Source-Robotics/RAFT-teleoperation-arm/datasheets/PAROL6_dims.png

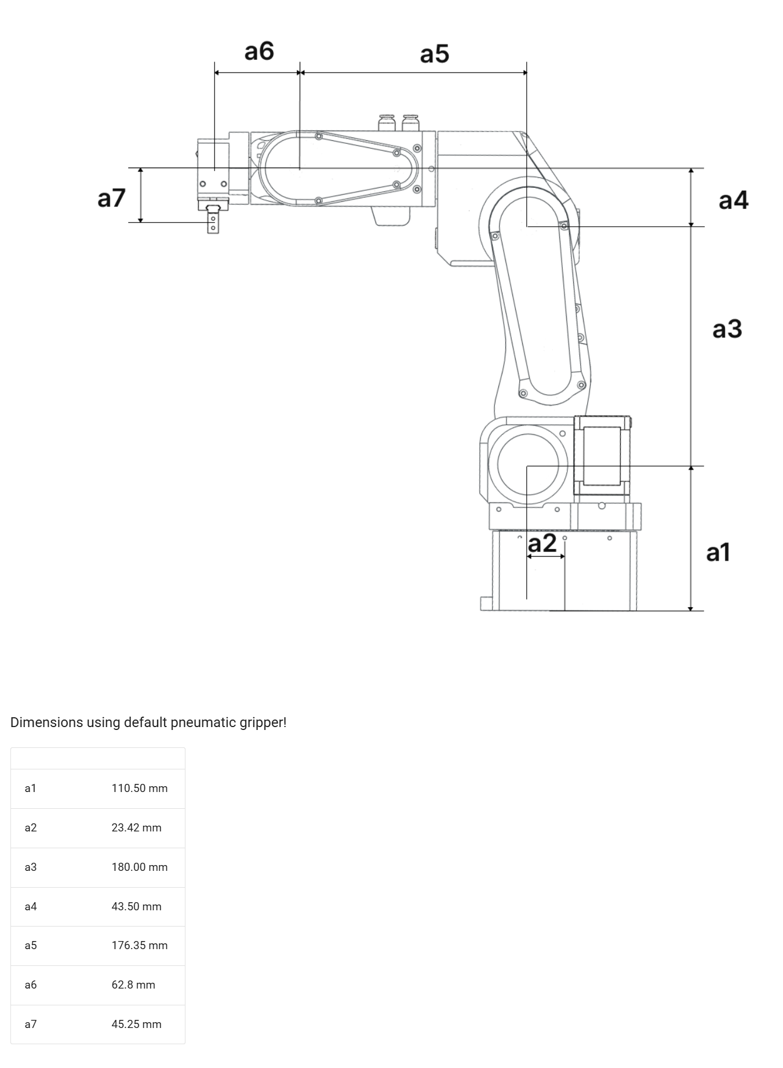
datasheets/PAROL6_dims.png
