Source-Robotics/RAFT-teleoperation-arm/Photos/render_back_dark.png

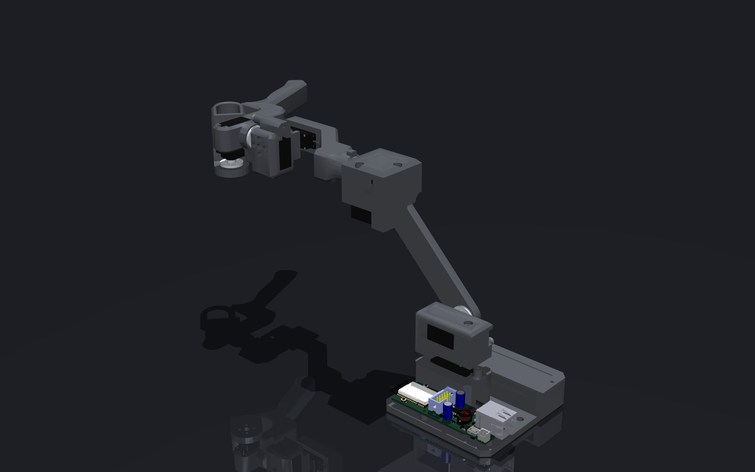
Photos/render_back_dark.png
