Source-Robotics/RAFT-teleoperation-arm/Photos/render_poses_dark.png

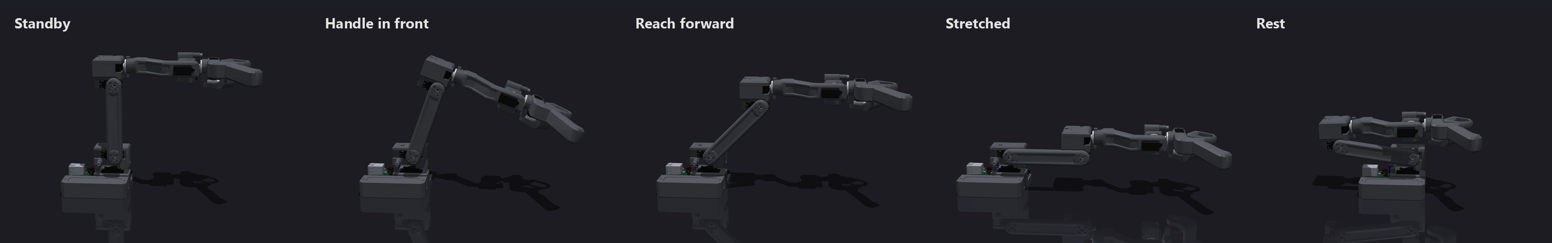
Photos/render_poses_dark.png
