Source-Robotics/RAFT-teleoperation-arm/BOM reference images/README.md

# BOM reference images

Pictures for the rows of [`BOM.md`](../BOM.md), to help find the same or an equivalent part from another supplier.
Each picture keeps its own licence. The CERN-OHL-S and GPL licences of this repository do not cover them.

| File | What | Source | Licence |
|---|---|---|---|
| `HLS3606M_servo.jpg` | The HLS3606M and what comes in its box: lead, aluminium horn, screws, splitter board, plastic horns | Feetech, from the HLS3606 datasheet ([`datasheets/HL_3606_C001_datasheet.pdf`](../datasheets/HL_3606_C001_datasheet.pdf)) | © Feetech |
| `ESP32-POE.jpg` | Olimex ESP32-PoE | Olimex, from the ESP32-POE user manual ([`datasheets/ESP32-POE-user-manual.pdf`](../datasheets/ESP32-POE-user-manual.pdf)) | © Olimex |
| `TTLinker_mini.jpg` | TTLinker mini | From the TTLinker datasheet ([`datasheets/TTLINKER.pdf`](../datasheets/TTLINKER.pdf)) | © its maker |
| `bench_power_supply.jpg` | A bench power supply | [Derrick Parker, Wikimedia Commons](https://commons.wikimedia.org/wiki/File:Bench_power_supply.jpg) | [CC0 1.0](https://creativecommons.org/publicdomain/zero/1.0/) |
| `toggle_switch.jpg` | A toggle switch | [Jason Zack (Jszack) at English Wikipedia, Wikimedia Commons](https://commons.wikimedia.org/wiki/File:On-Off_Switch.jpg) | [CC BY-SA 2.5](https://creativecommons.org/licenses/by-sa/2.5/) |
| `PoE_injector.jpg` | A PoE injector: data in, data and power out | [deavmi, Wikimedia Commons](https://commons.wikimedia.org/wiki/File:Power_over_Ethernet_injector.jpg) | [CC BY-SA 4.0](https://creativecommons.org/licenses/by-sa/4.0/) |
| `extension_spring.jpg` | An extension spring with a hook at each end | [Jean-Jacques MILAN, Wikimedia Commons](https://commons.wikimedia.org/wiki/File:Ressort_de_traction_%C3%A0_spires_jointives.jpg) | [CC BY-SA 3.0](https://creativecommons.org/licenses/by-sa/3.0/) |
| `braided_line.jpg` | Braided fishing line (Dyneema braid is sold this way) | [George Chernilevsky, Wikimedia Commons](https://commons.wikimedia.org/wiki/File:Fishing_lines_2025_G1.jpg) | [CC BY 4.0](https://creativecommons.org/licenses/by/4.0/) |
| `eyelet.png` | Ceramic thread-guide eyelet and a PTFE tube slice | Rendered for RAFT | CERN-OHL-S-2.0, as the rest of the hardware |

The Commons pictures are scaled down from the originals and otherwise unchanged.
