Source-Robotics/RAFT-teleoperation-arm/BOM reference images/bench_power_supply.jpg

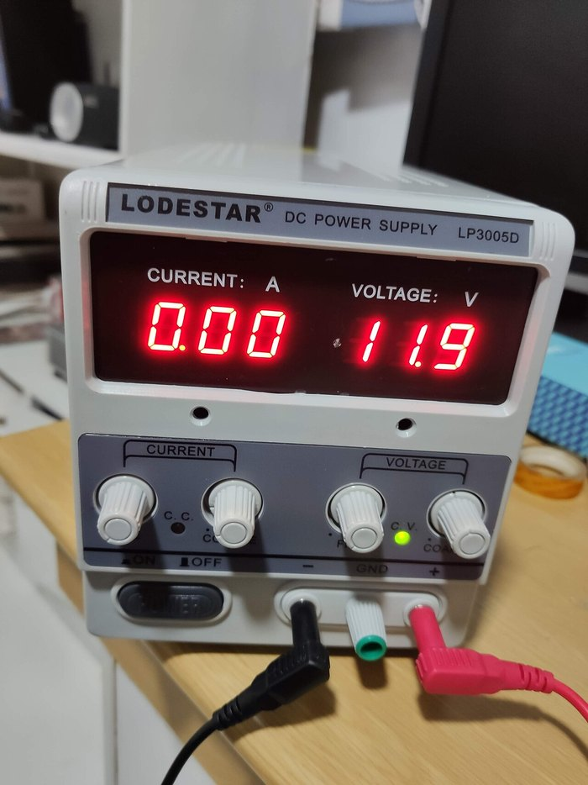
BOM reference images/bench_power_supply.jpg
