Source-Robotics/RAFT-teleoperation-arm/BOM reference images/braided_line.jpg

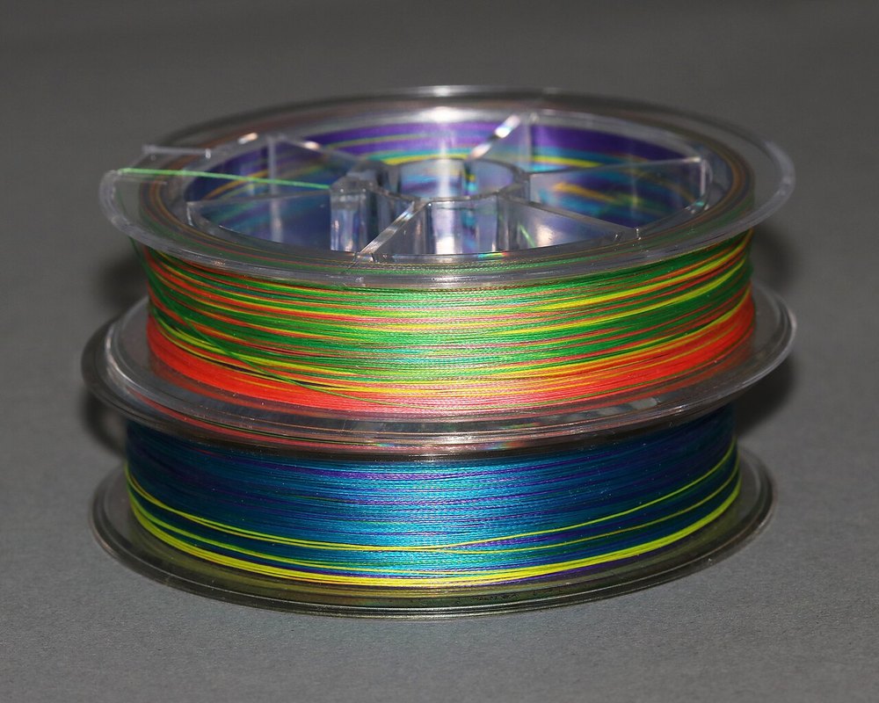
BOM reference images/braided_line.jpg
