Source-Robotics/RAFT-teleoperation-arm/BOM reference images/ESP32-POE.jpg

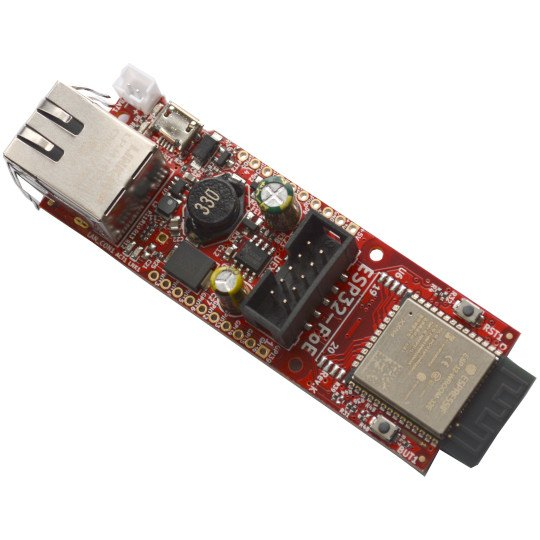
BOM reference images/ESP32-POE.jpg
