Source-Robotics/RAFT-teleoperation-arm/BOM reference images/extension_spring.jpg

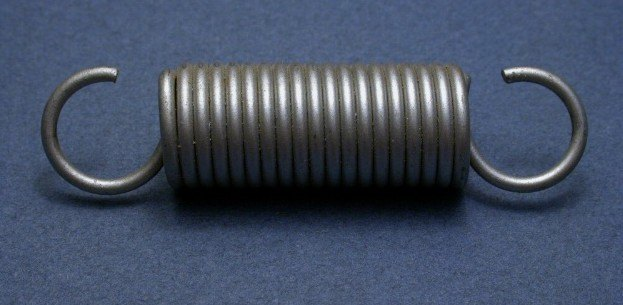
BOM reference images/extension_spring.jpg
