Source-Robotics/RAFT-teleoperation-arm/BOM reference images/eyelet.png

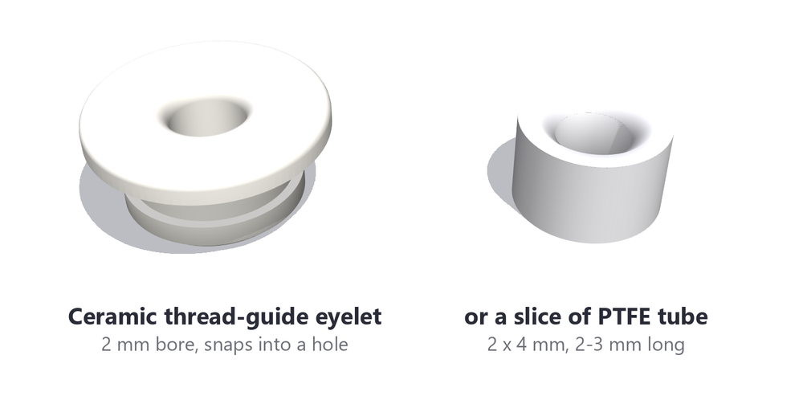
BOM reference images/eyelet.png
