Source-Robotics/RAFT-teleoperation-arm/BOM reference images/HLS3606M_servo.jpg

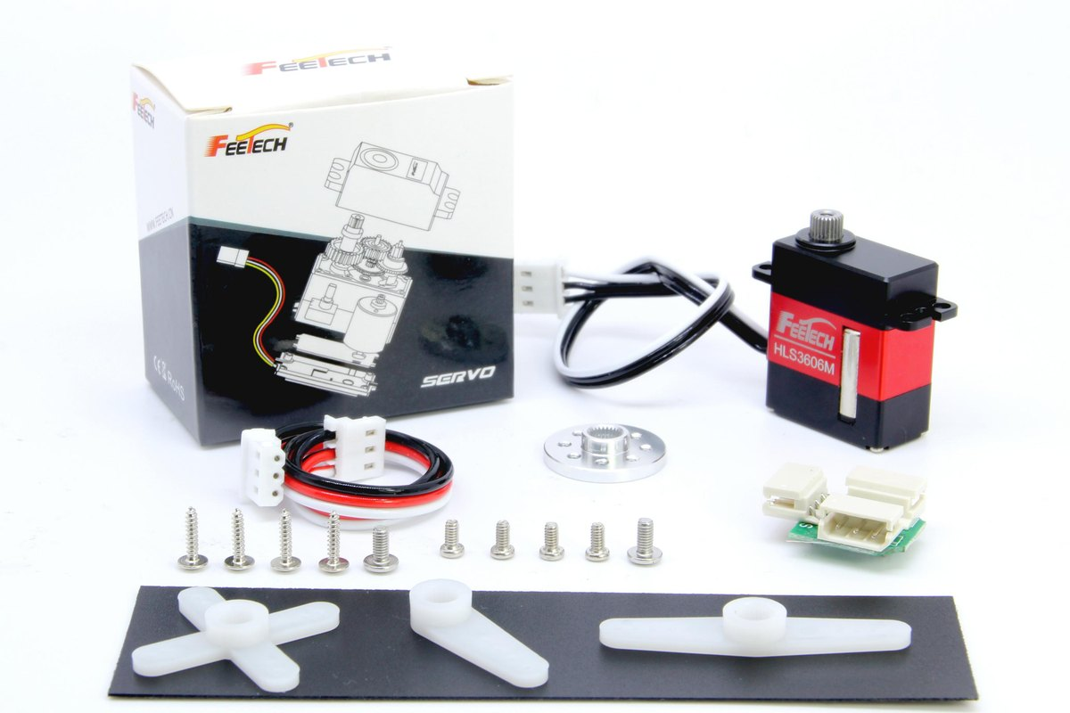
BOM reference images/HLS3606M_servo.jpg
