Source-Robotics/RAFT-teleoperation-arm/BOM reference images/PoE_injector.jpg

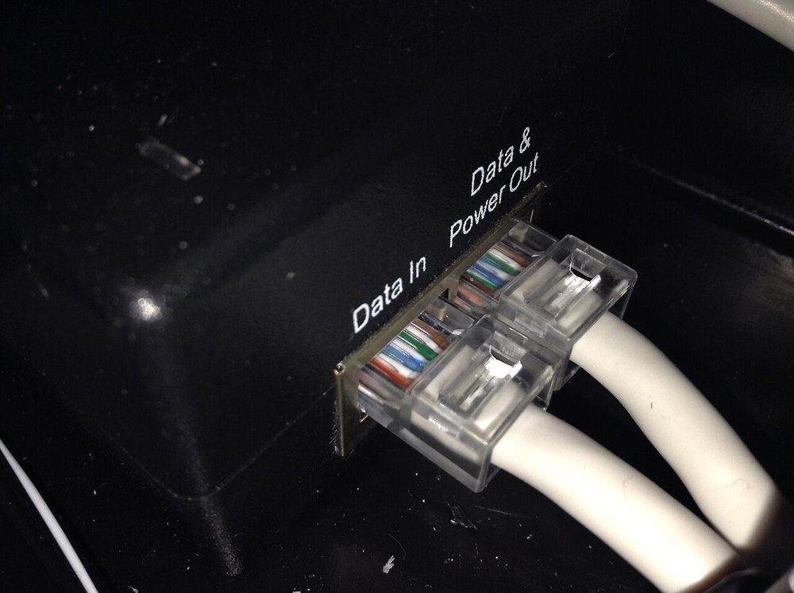
BOM reference images/PoE_injector.jpg
