Source-Robotics/RAFT-teleoperation-arm/BOM reference images/toggle_switch.jpg

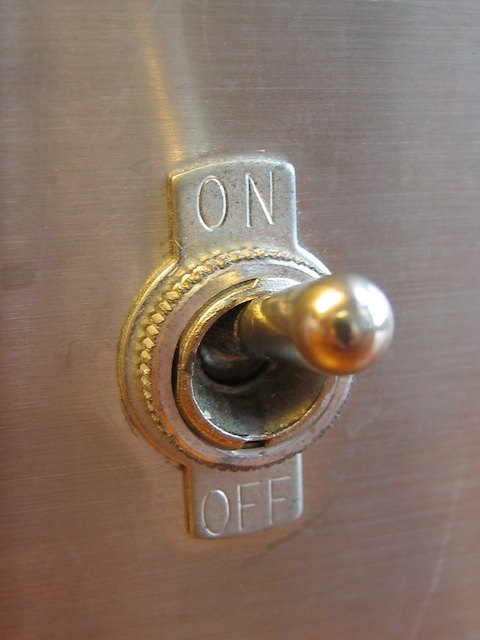
BOM reference images/toggle_switch.jpg
