Source-Robotics/RAFT-teleoperation-arm/BOM reference images/TTLinker_mini.jpg

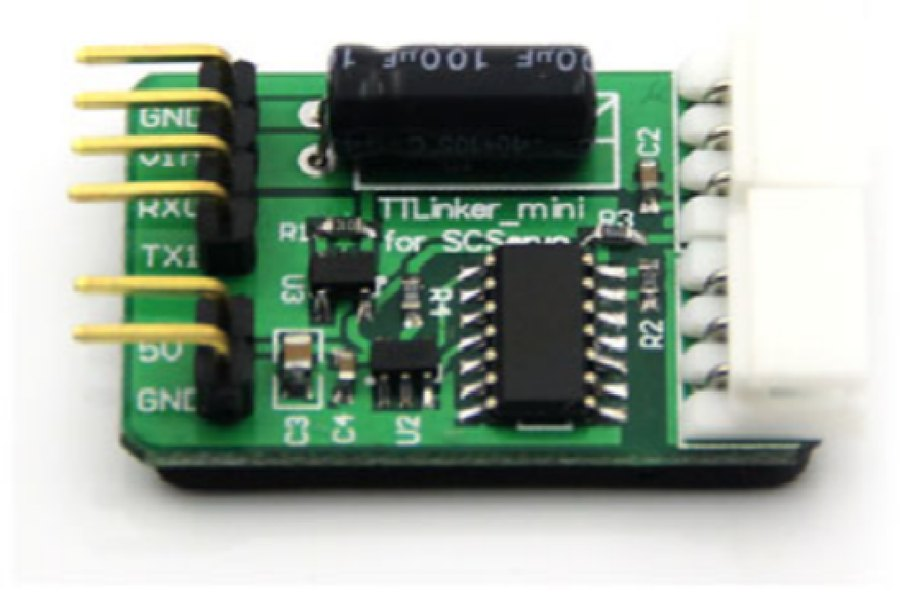
BOM reference images/TTLinker_mini.jpg
