Source-Robotics/RAFT-teleoperation-arm/3D print files/RAFT_BUNDLE_2.3mf

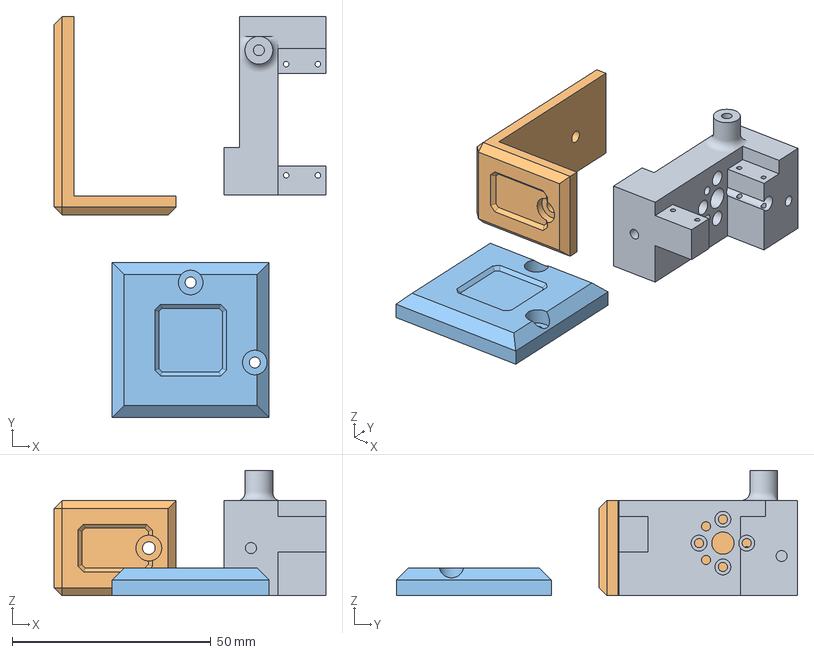
[picture p18: CAD file, 2026-05-04]
3D print files/RAFT_BUNDLE_2.3mf
68.4 x 101.0 x 31.6 mm
Part2^Assem1.STL
Part6^Assem1.STL
Part3^Assem1.STL
