Source-Robotics/RAFT-teleoperation-arm/firmware/tools/sim/model/meshes/link3.stl

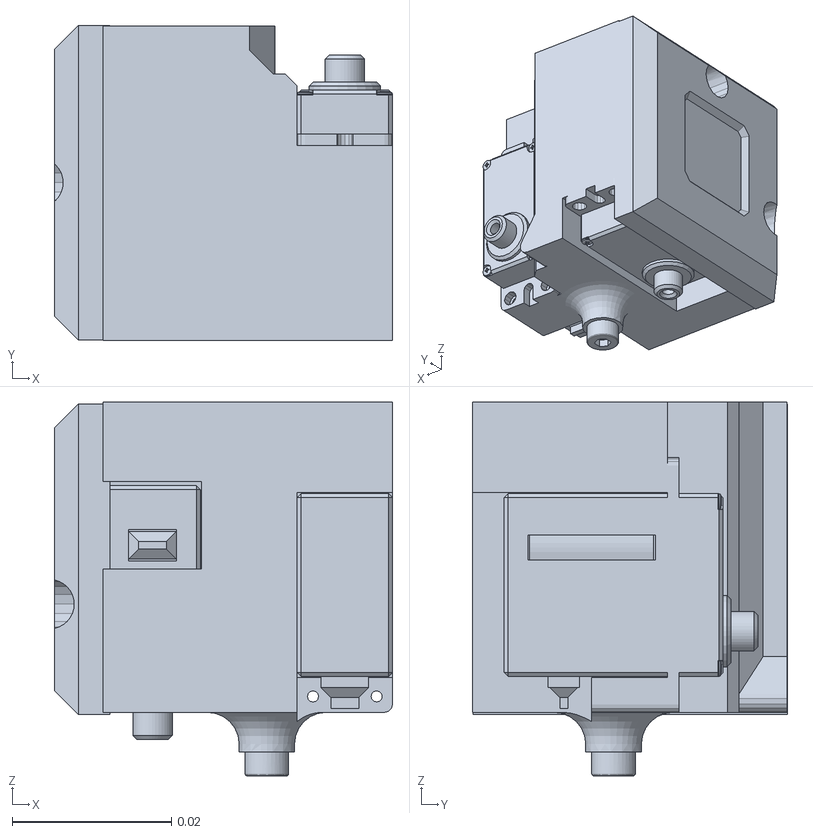
[picture p19: CAD file, 2026-11-05]
firmware/tools/sim/model/meshes/link3.stl
0.0425 x 0.0396 x 0.047
