Source-Robotics/RAFT-teleoperation-arm/STEP files/Lower_arm.STEP

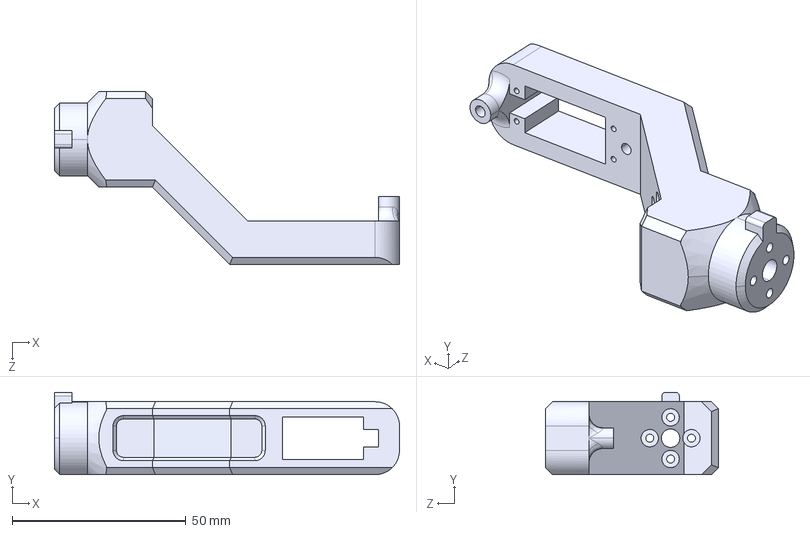
[picture p20: CAD file, 2026-05-04]
STEP files/Lower_arm.STEP
99.4 x 23.7 x 49.8 mm
