Source-Robotics/RAFT-teleoperation-arm/3D print files/RAFT_BUNDLE_1.3mf

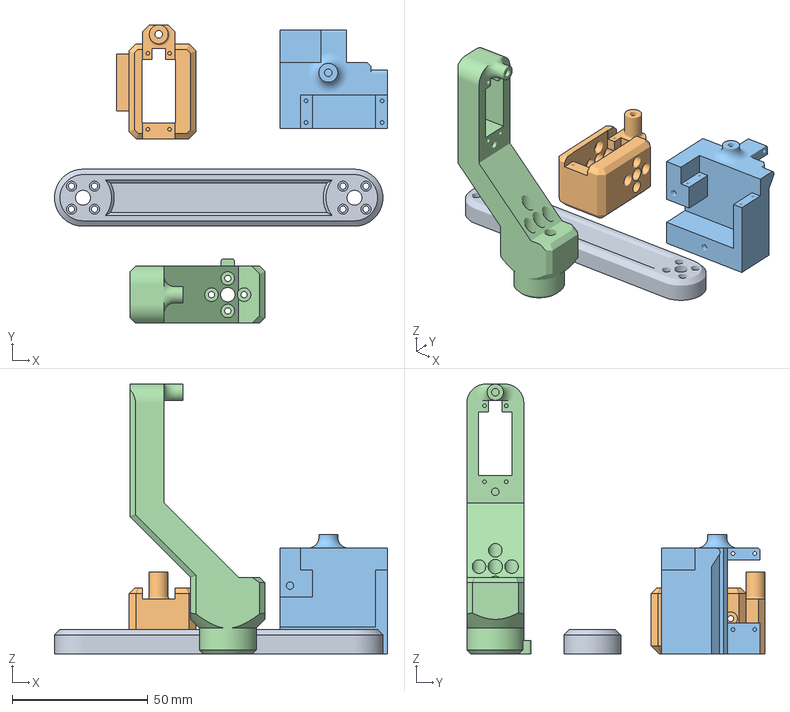
[picture p21: CAD file, 2026-05-04]
3D print files/RAFT_BUNDLE_1.3mf
122.7 x 109.9 x 99.4 mm
upper_Arm.STL
Part5^Assem1.STL
Part1^Assem1.STL
Part4^Assem1.STL
