Source-Robotics/RAFT-teleoperation-arm/firmware/tools/sim/model/meshes/link2.stl

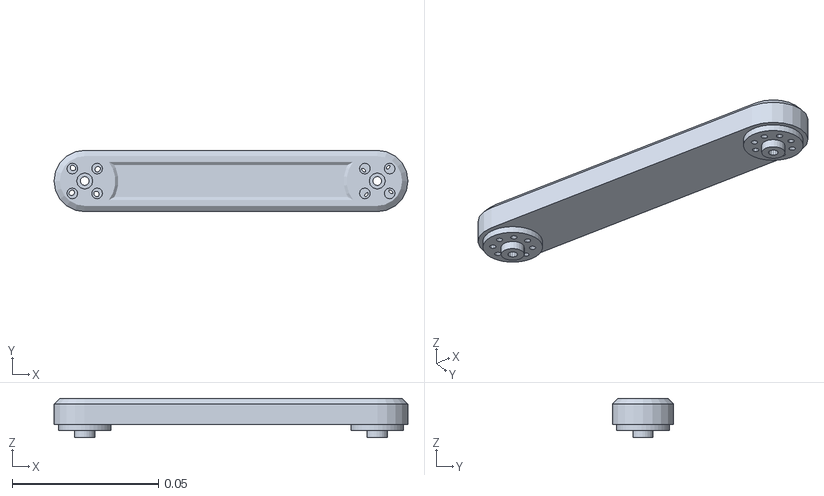
[picture p22: CAD file, 2026-11-05]
firmware/tools/sim/model/meshes/link2.stl
0.121 x 0.021 x 0.0135
