Source-Robotics/RAFT-teleoperation-arm/STEP files/Gripper_trigger.STEP

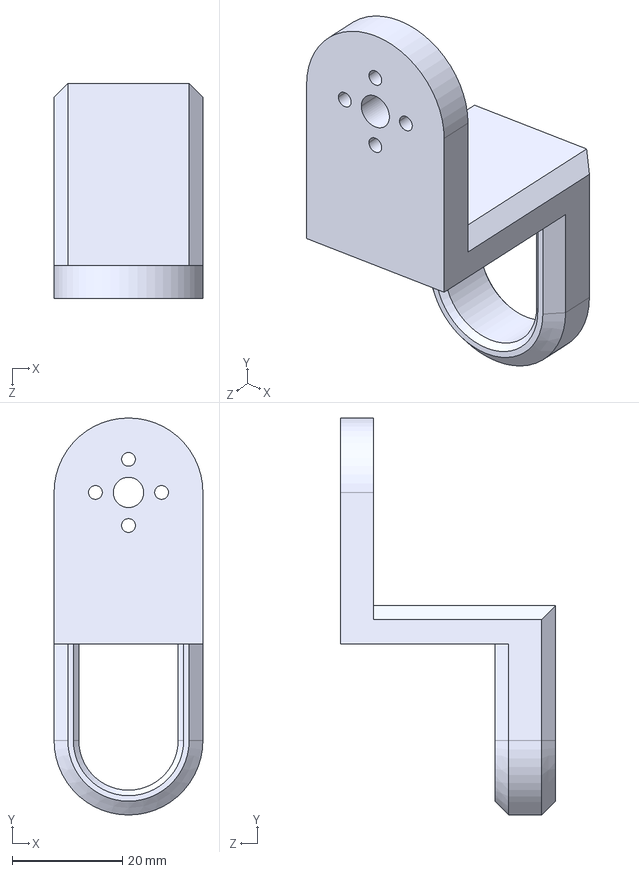
[picture p23: CAD file, 2026-05-04]
STEP files/Gripper_trigger.STEP
27.0 x 72.0 x 39.0 mm
