Source-Robotics/RAFT-teleoperation-arm/firmware/tools/sim/model/meshes/link4.stl

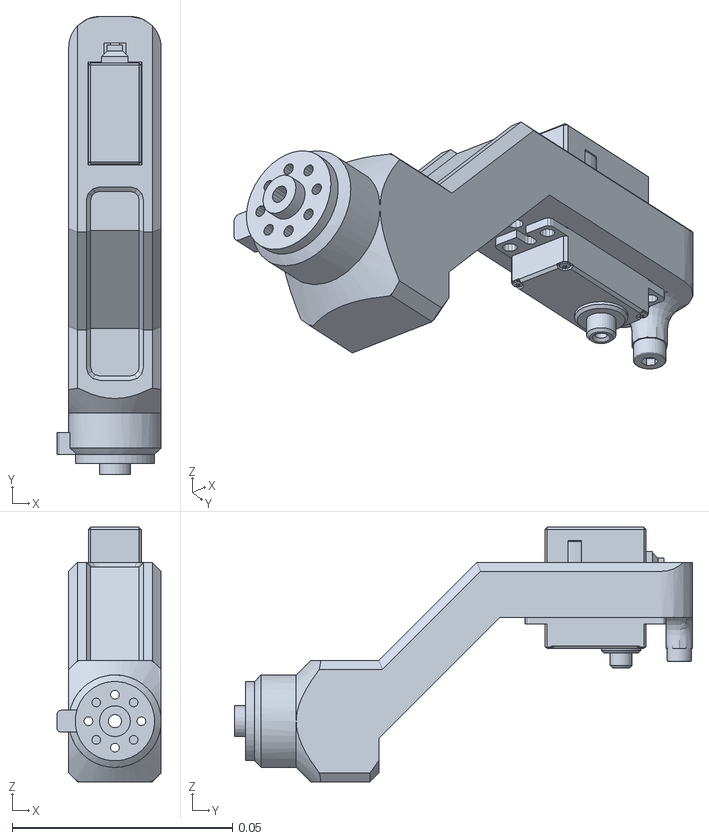
[picture p24: CAD file, 2026-11-05]
firmware/tools/sim/model/meshes/link4.stl
0.0237 x 0.104 x 0.0578
