Source-Robotics/RAFT-teleoperation-arm/STEP files/Wrist.STEP

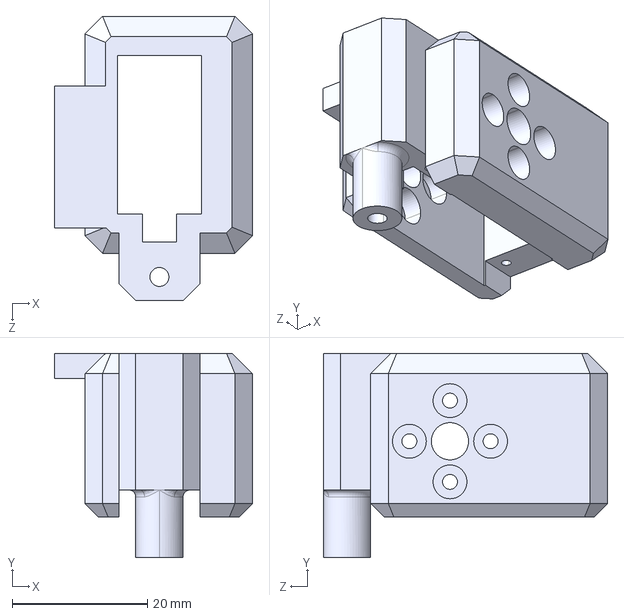
[picture p25: CAD file, 2026-05-04]
STEP files/Wrist.STEP
29.3 x 30.2 x 42.0 mm
