Source-Robotics/RAFT-teleoperation-arm/firmware/tools/sim/model/meshes/link1.stl

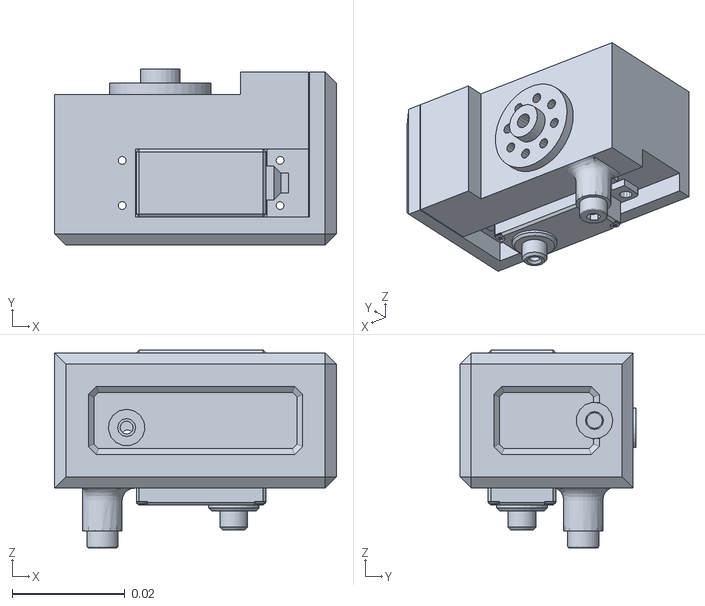
[picture p26: CAD file, 2026-11-05]
firmware/tools/sim/model/meshes/link1.stl
0.05 x 0.0312 x 0.0351
