Source-Robotics/RAFT-teleoperation-arm/STEP files/Elbow_llid.STEP

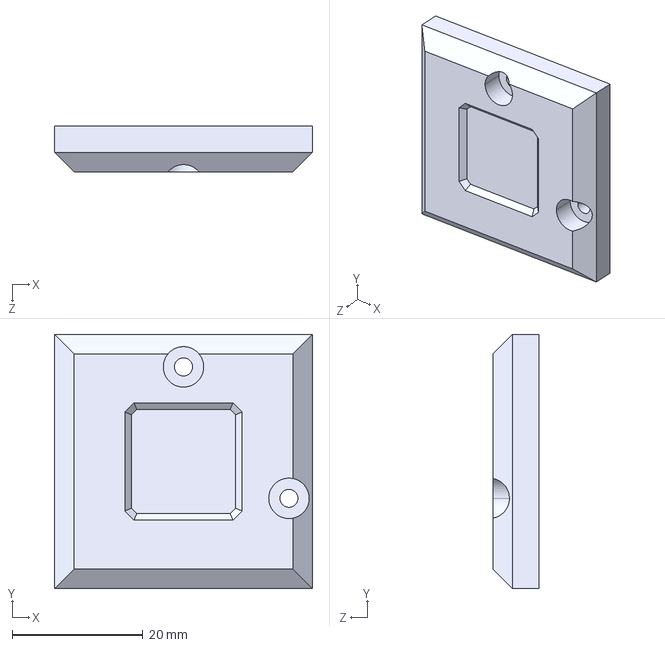
[picture p27: CAD file, 2026-05-04]
STEP files/Elbow_llid.STEP
39.5 x 39.0 x 7.00 mm
