Source-Robotics/RAFT-teleoperation-arm/firmware/tools/sim/model/meshes/link5.stl

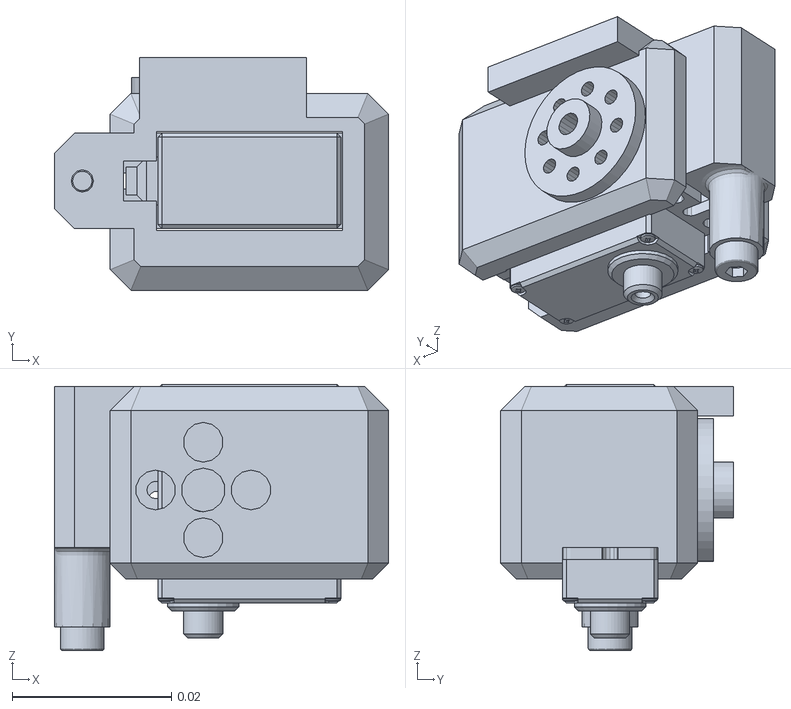
[picture p28: CAD file, 2026-11-05]
firmware/tools/sim/model/meshes/link5.stl
0.042 x 0.0292 x 0.0335
