Source-Robotics/RAFT-teleoperation-arm/STEP files/Shoulder.STEP

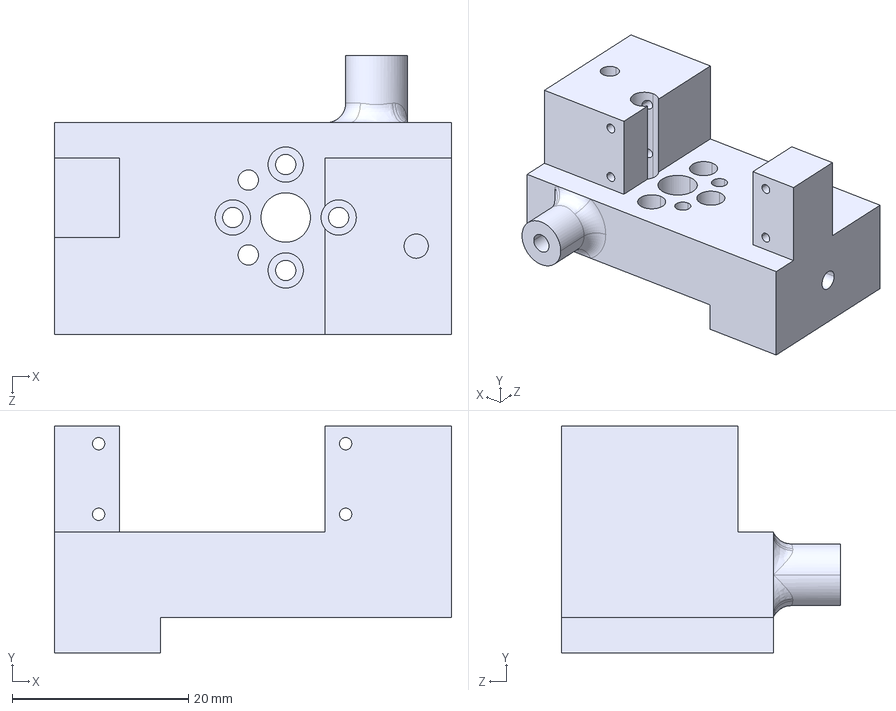
[picture p29: CAD file, 2026-05-04]
STEP files/Shoulder.STEP
45.0 x 25.7 x 31.6 mm
