Source-Robotics/RAFT-teleoperation-arm/firmware/tools/sim/model/meshes/base_link.stl

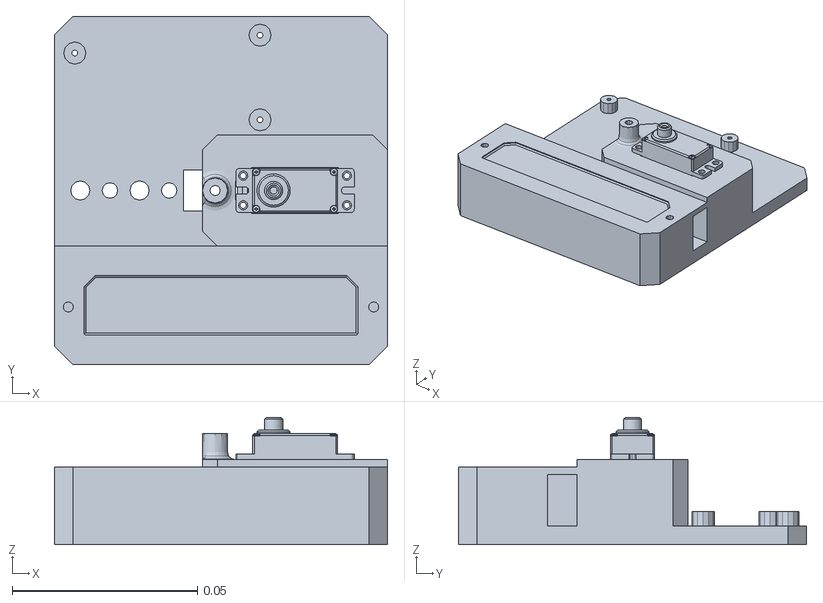
[picture p30: CAD file, 2026-11-05]
firmware/tools/sim/model/meshes/base_link.stl
0.09 x 0.094 x 0.0344
