Source-Robotics/RAFT-teleoperation-arm/STEP files/Gripper_handle.STEP

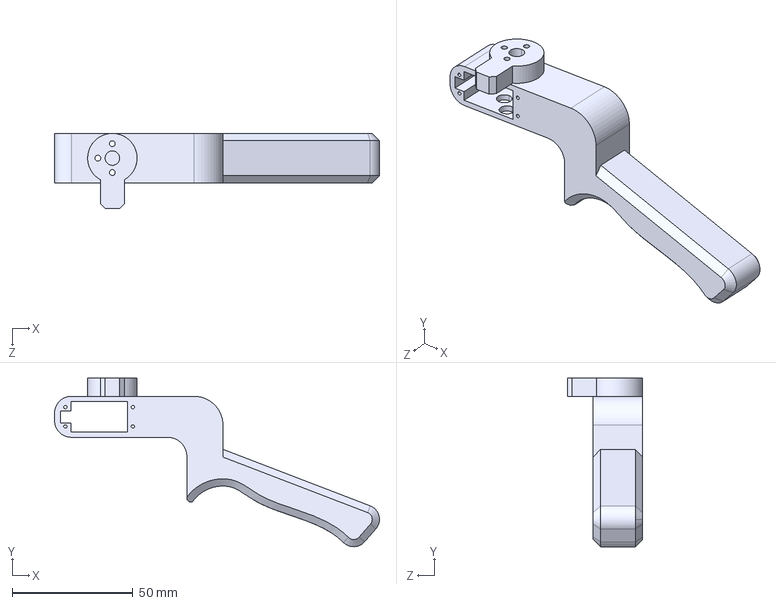
[picture p31: CAD file, 2026-05-04]
STEP files/Gripper_handle.STEP
134.8 x 69.9 x 31.2 mm
