Source-Robotics/RAFT-teleoperation-arm/firmware/tools/sim/model/meshes/gripper_trigger.stl

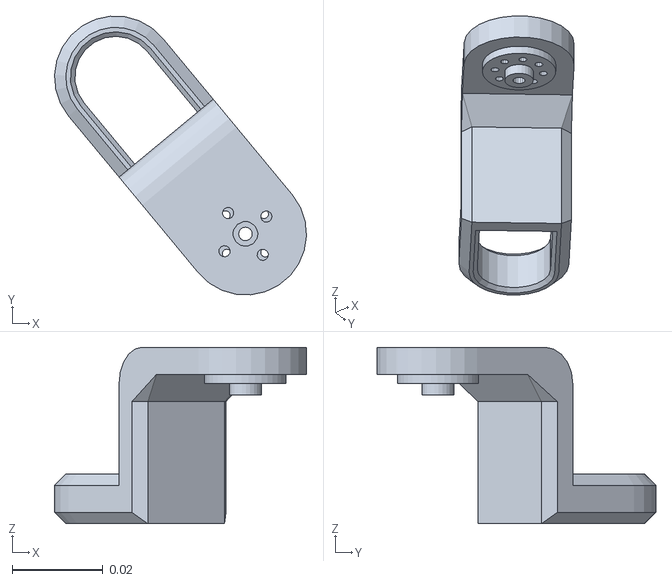
[picture p32: CAD file, 2026-11-05]
firmware/tools/sim/model/meshes/gripper_trigger.stl
0.0557 x 0.0616 x 0.039
