Source-Robotics/RAFT-teleoperation-arm/STEP files/Shoulder_lid.STEP

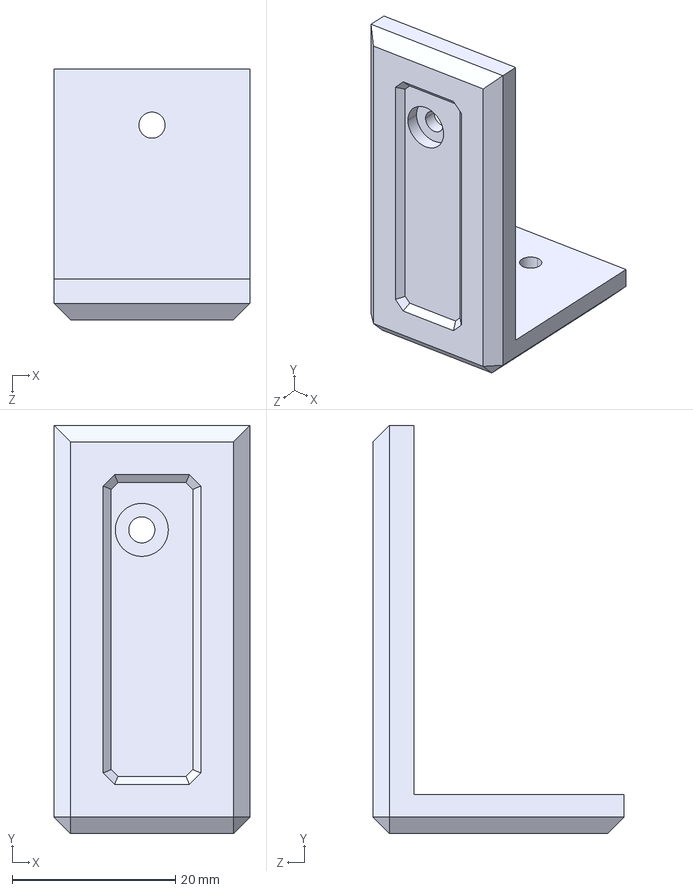
[picture p33: CAD file, 2026-05-04]
STEP files/Shoulder_lid.STEP
24.0 x 50.0 x 30.7 mm
