Source-Robotics/RAFT-teleoperation-arm/firmware/tools/sim/model/meshes/link6.stl

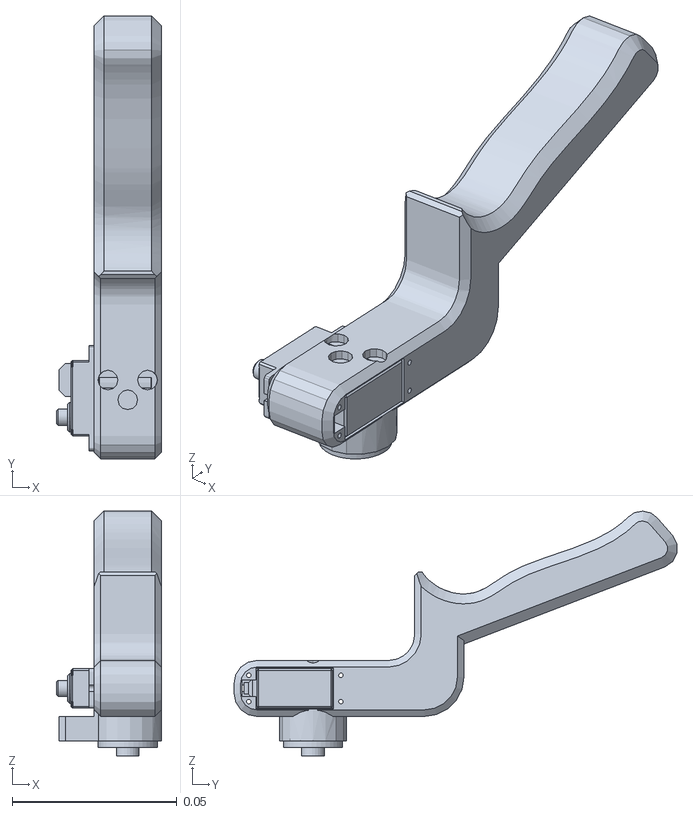
[picture p34: CAD file, 2026-11-05]
firmware/tools/sim/model/meshes/link6.stl
0.0319 x 0.135 x 0.0744
