Source-Robotics/RAFT-teleoperation-arm/STEP files/Base_lid.STEP

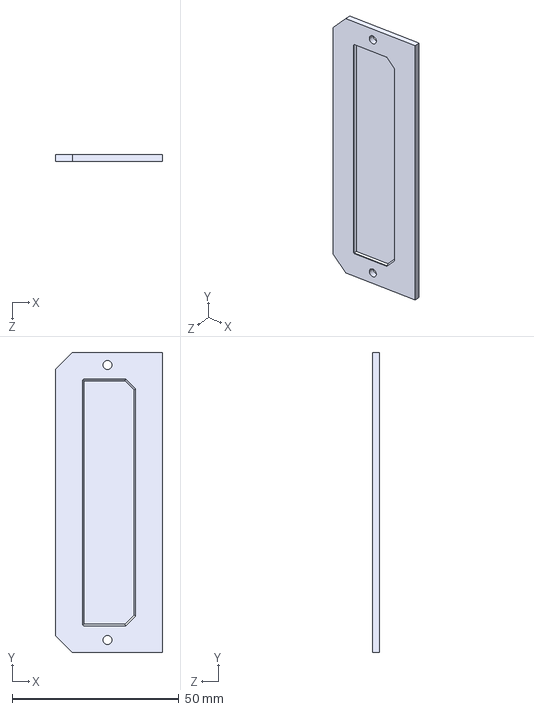
[picture p35: CAD file, 2026-05-04]
STEP files/Base_lid.STEP
32.0 x 90.0 x 2.00 mm
