Source-Robotics/RAFT-teleoperation-arm/STEP files/Upper_arm.STEP

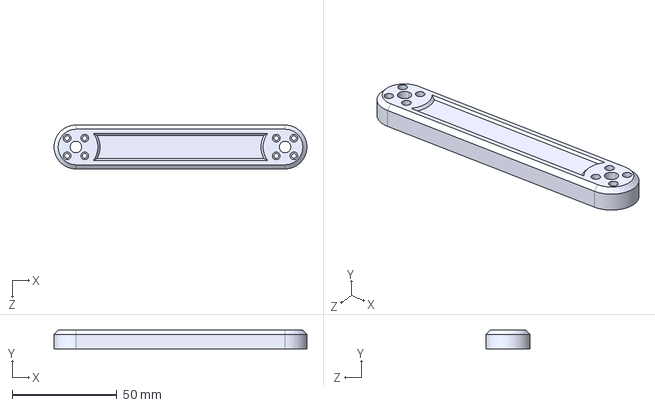
[picture p36: CAD file, 2026-05-04]
STEP files/Upper_arm.STEP
121.0 x 9.00 x 21.0 mm
