Source-Robotics/RAFT-teleoperation-arm/STEP files/Base.STEP

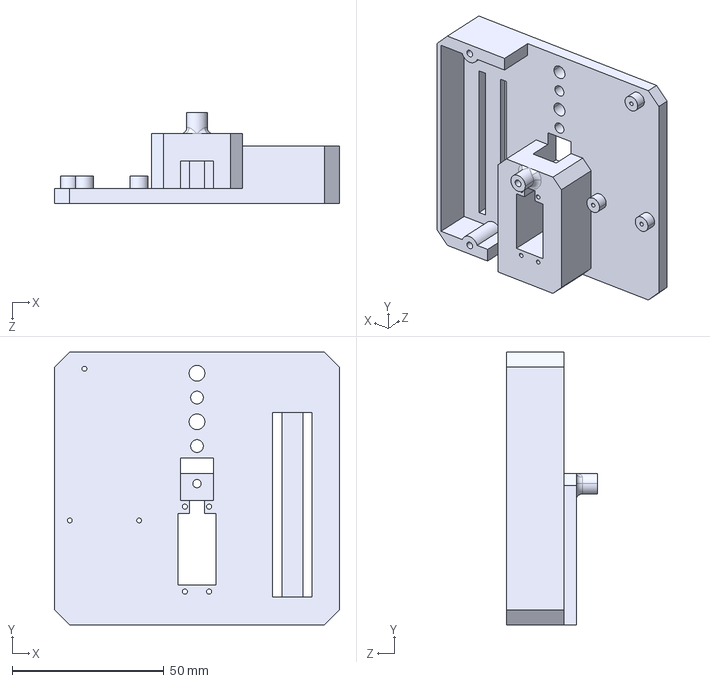
[picture p37: CAD file, 2026-05-04]
STEP files/Base.STEP
94.0 x 90.0 x 30.0 mm
