Source-Robotics/RAFT-teleoperation-arm/STEP files/Elbow.STEP

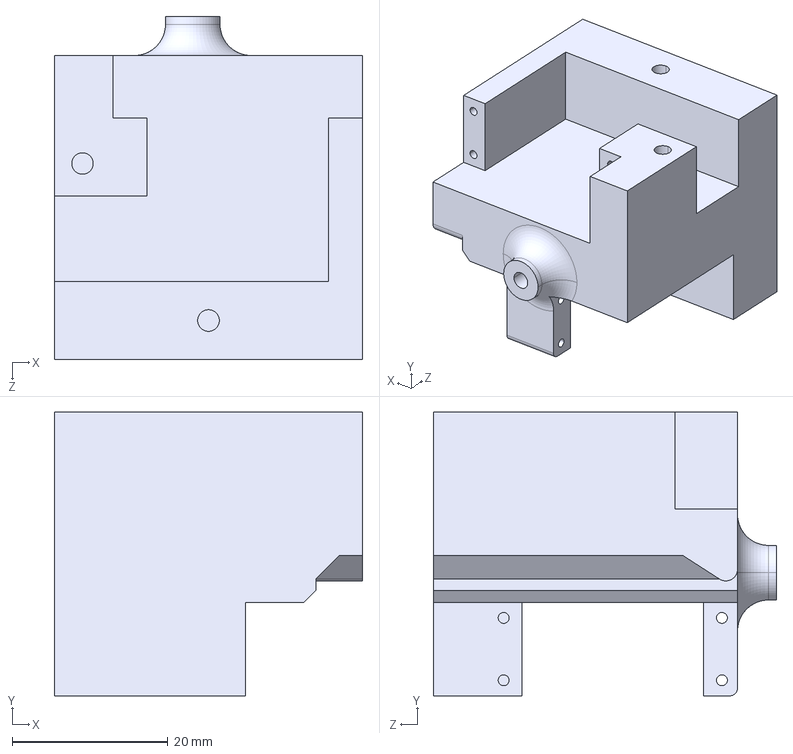
[picture p38: CAD file, 2026-05-04]
STEP files/Elbow.STEP
39.5 x 36.4 x 44.0 mm
