Source-Robotics/RAFT-teleoperation-arm/3D print files/RAFT Teleop Arm Print Table - Sheet1.pdf

We used a Prusa MK4 with the default Prusament PETG filament profile. To ensure your RAFT robot functions properly, please try to match these print settings on your own printer. While the mass doesn't need to be exact for every part, you should aim for the values listed in the table once your model is sliced. Note: Make sure to deduct the mass of any support

### material! Mass in the table is for the parts without any support material!

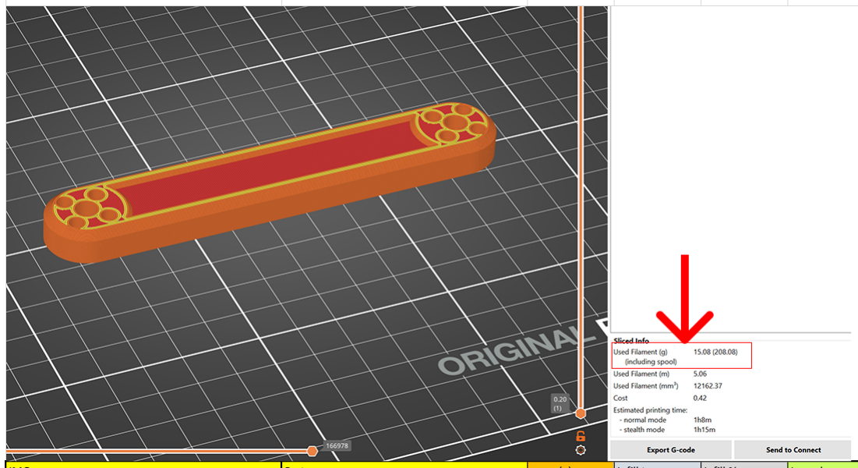
[picture p55: figure]
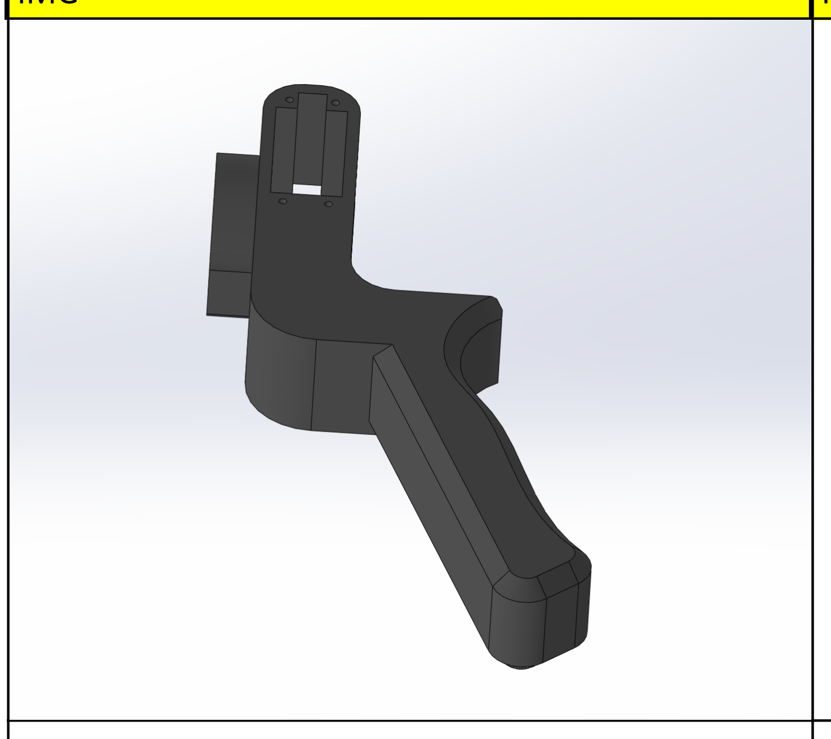
[picture p56: figure]

IMG | Part name | mass (g) | Infill type | Infill % | Layer h | Top layers | Bot layers | Perimeters
| Gripper handle | 33 | honey | 25 | 0.15 | 6 | 5 | 3

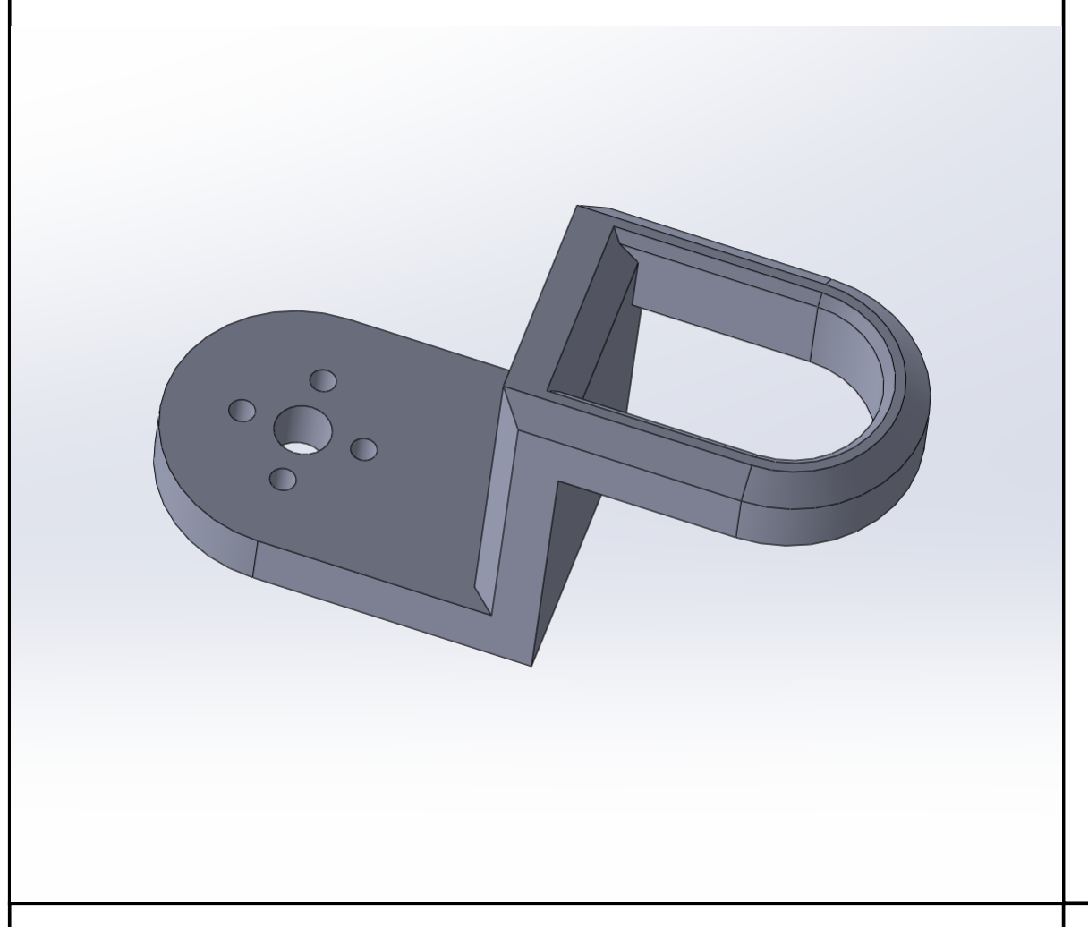
[picture p57: figure]

| Gripper trigger | 13 | honey | 25 | 0.15 | 6 | 5 | 3

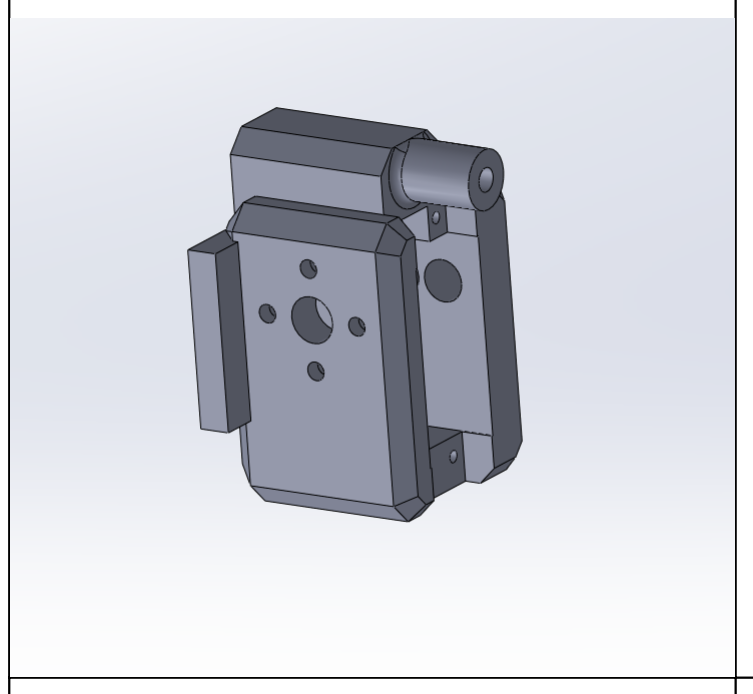
[picture p58: figure]

| Wrist | 12.7 | honey | 25 | 0.15 | 6 | 5 | 3

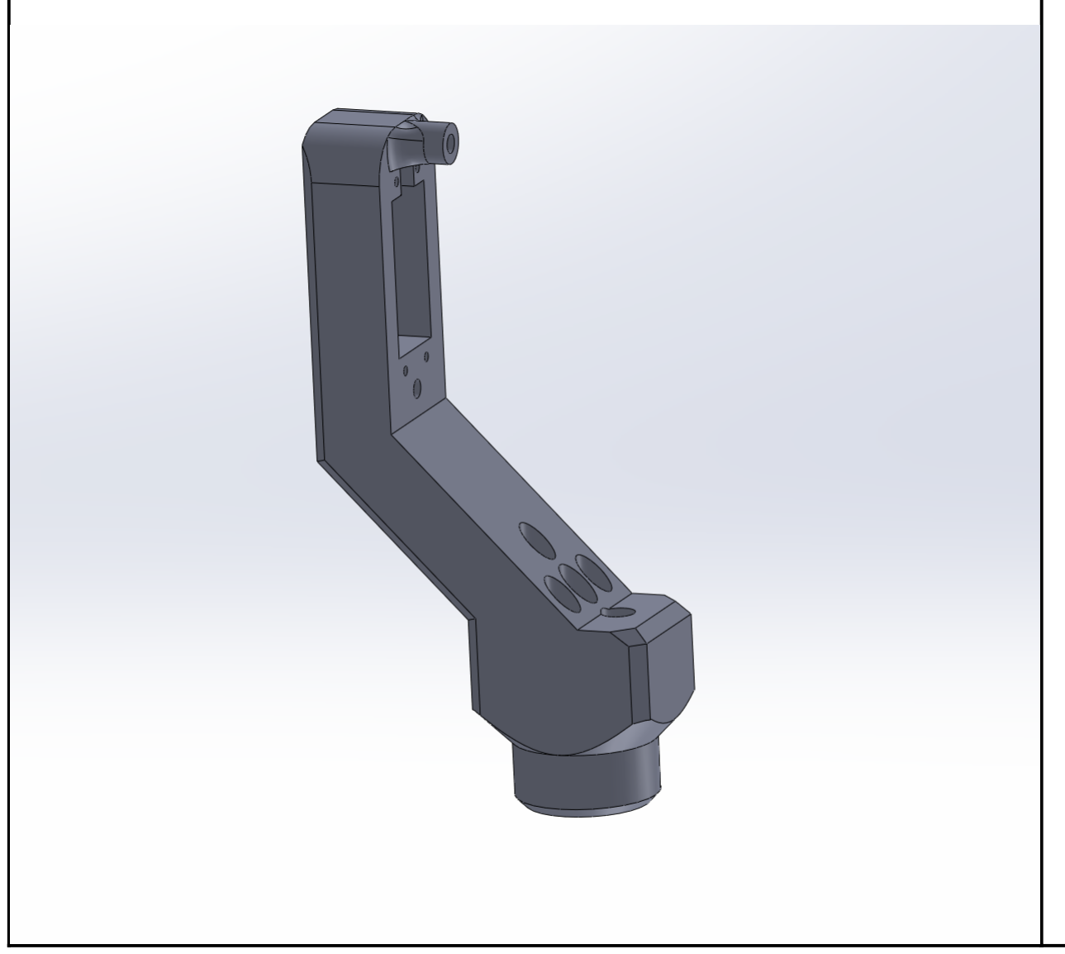
[picture p59: figure]

| Lower arm | 23.7 | honey | 25 | 0.15 | 6 | 5 | 3

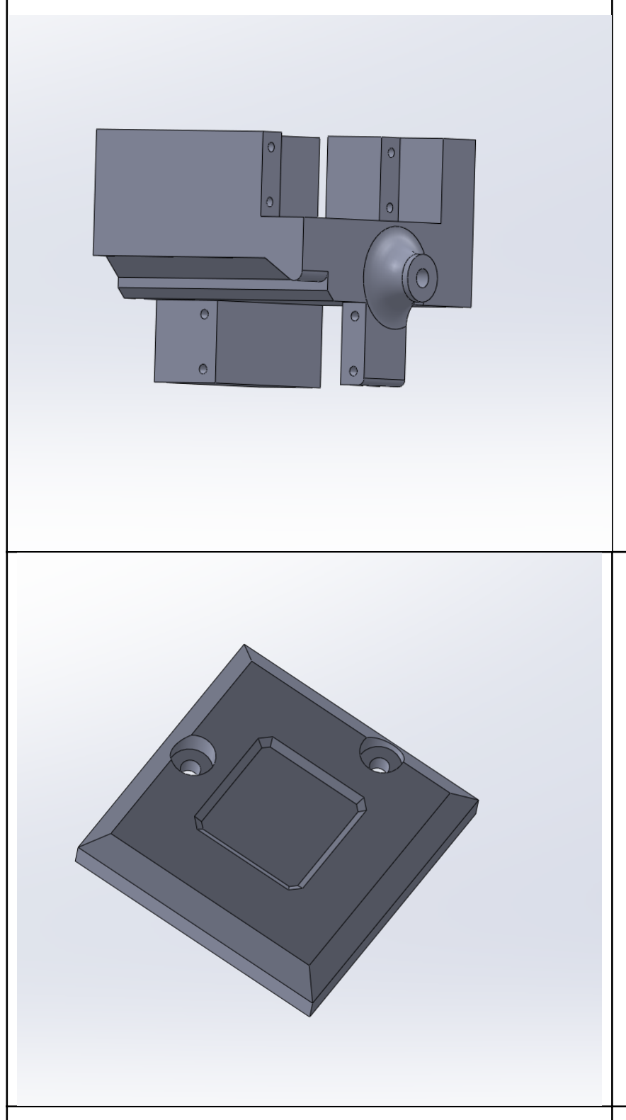
[picture p60: figure]

Elbow | 21.7 | honey | 25 | 0.15 | 6 | 5 | 3
Elbow lid | 7.6 | honey | 25 | 0.15 | 6 | 5 | 3

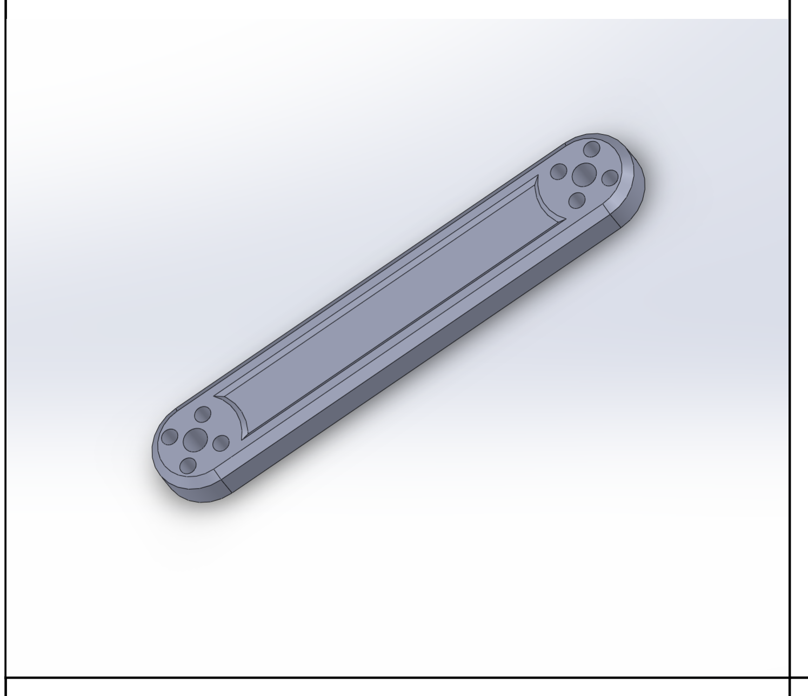
[picture p61: figure]

Upper arm | 15.6 | honey | 25 | 0.15 | 6 | 5 | 3

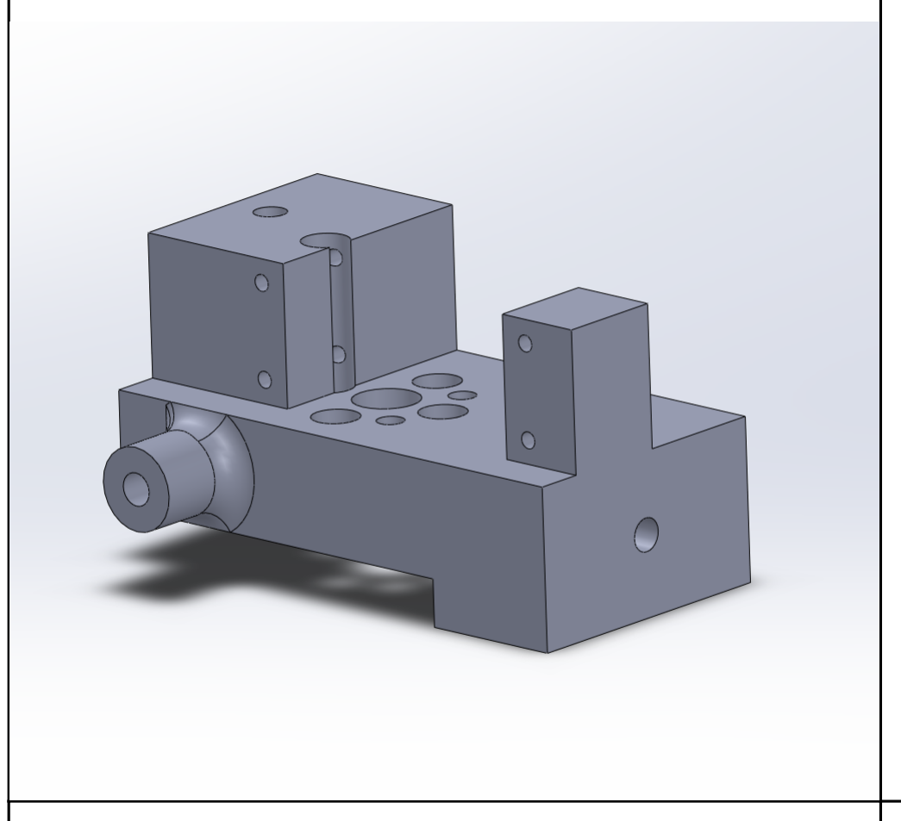
[picture p62: figure]

Shoulder | 13 | honey | 25 | 0.15 | 6 | 5 | 3

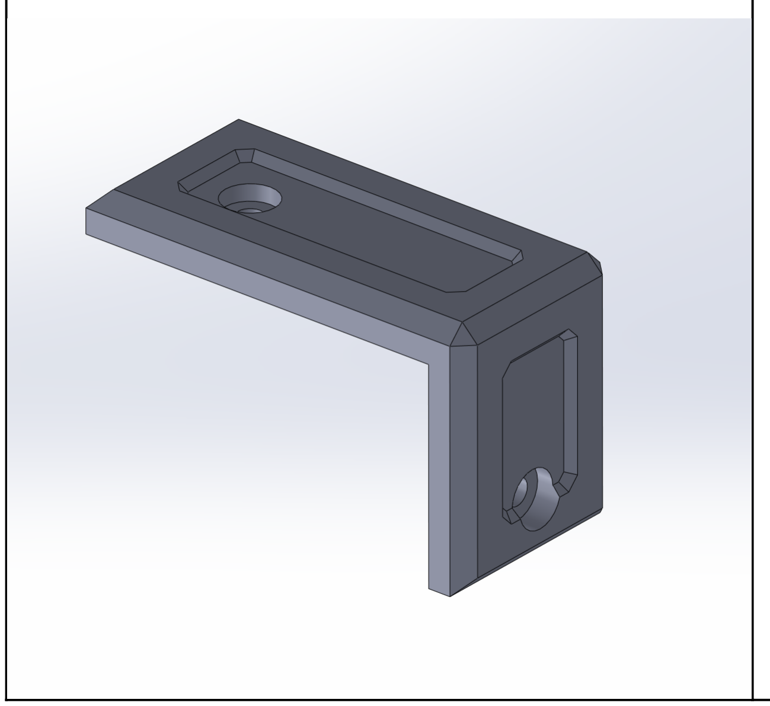
[picture p63: figure]

Shoulder lid | 7.8 | honey | 25 | 0.15 | 6 | 5 | 3

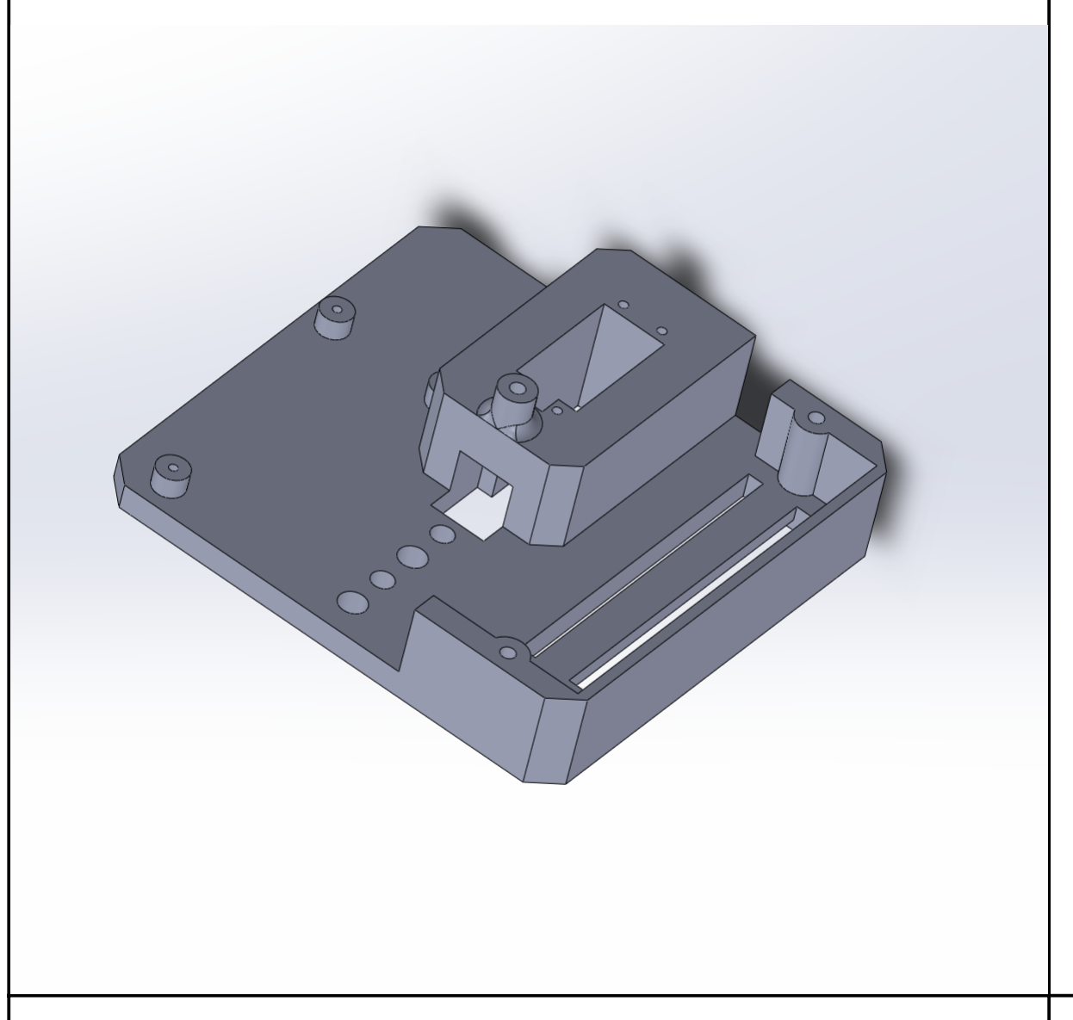
[picture p64: figure]

Base | 51 | honey | 25 | 0.15 | 6 | 5 | 3

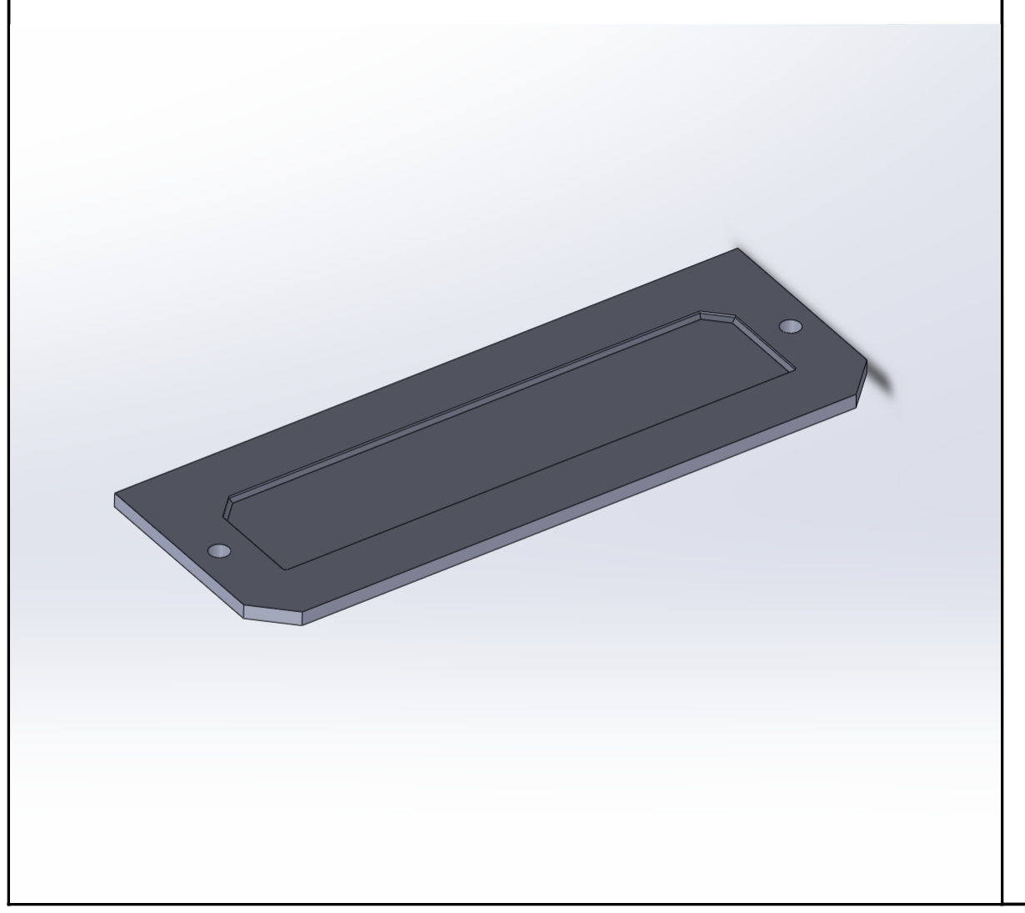
[picture p65: figure]

Base lid | 5.7 | honey | 25 | 0.15 | 6 | 5 | 3
