Source-Robotics/RAFT-teleoperation-arm/firmware/tools/sim/model/RAFT.urdf

<?xml version="1.0" encoding="utf-8"?>
<!-- RAFT leader arm. GENERATED by firmware/tools/gen_model.py from the CM6 DH table,
     the RAFT link lengths and the SolidWorks mass properties in RAFT inertials.pdf. Do not hand-edit.
     Joint i rotates about the z axis of DH frame i-1; q = 0 is the CAD / PAR6 standby pose.
     PAR6/RCB DH angles: theta = q + [0, -pi/2, pi, 0, 0, pi]. Joint limits are placeholders until measured. -->
<robot name="RAFT">
  <link name="base_link">
    <inertial>
      <origin xyz="-0.00730483363719 -0.000420419325433 0.010516627165" rpy="0 0 0"/>
      <mass value="0.08776"/>
      <inertia ixx="5.18931e-05" ixy="2.25048e-06" ixz="-3.40251e-06" iyy="6.09566e-05" iyz="3.09482e-06" izz="0.000102433"/>
    </inertial>
    <visual>
      <origin xyz="0 0 0" rpy="0 0 0"/>
      <geometry><mesh filename="meshes/base_link.stl"/></geometry>
      <material name="grey"><color rgba="0.8 0.8 0.8 1"/></material>
    </visual>
    <collision>
      <origin xyz="0 0 0" rpy="0 0 0"/>
      <geometry><mesh filename="meshes/base_link.stl"/></geometry>
    </collision>
  </link>
  <link name="link1">
    <inertial>
      <origin xyz="0.00683 -0.0001 0.04872" rpy="0 0 0"/>
      <mass value="0.04314"/>
      <inertia ixx="4.90853e-06" ixy="7.971e-08" ixz="1.499e-07" iyy="8.81203e-06" iyz="1.294e-08" izz="8.88116e-06"/>
    </inertial>
    <visual>
      <origin xyz="0.013 0 0.05122" rpy="-1.57079632679 0 0"/>
      <geometry><mesh filename="meshes/link1.stl"/></geometry>
      <material name="grey"><color rgba="0.8 0.8 0.8 1"/></material>
    </visual>
    <collision>
      <origin xyz="0.013 0 0.05122" rpy="-1.57079632679 0 0"/>
      <geometry><mesh filename="meshes/link1.stl"/></geometry>
    </collision>
  </link>
  <joint name="joint1" type="revolute">
    <origin xyz="0 0 0" rpy="0 0 0"/>
    <parent link="base_link"/>
    <child link="link1"/>
    <axis xyz="0 0 1"/>
    <limit lower="-3.14159265359" upper="3.14159265359" effort="0.588" velocity="6"/>
  </joint>
  <link name="link2">
    <inertial>
      <origin xyz="0 -0.05 -0.02315" rpy="0 0 0"/>
      <mass value="0.0182"/>
      <inertia ixx="2.3591e-05" ixy="0" ixz="0" iyy="7.8223e-07" iyz="0" izz="2.40451e-05"/>
    </inertial>
    <visual>
      <origin xyz="0 -0.1 0" rpy="3.14159265359 0 -1.57079632679"/>
      <geometry><mesh filename="meshes/link2.stl"/></geometry>
      <material name="grey"><color rgba="0.8 0.8 0.8 1"/></material>
    </visual>
    <collision>
      <origin xyz="0 -0.1 0" rpy="3.14159265359 0 -1.57079632679"/>
      <geometry><mesh filename="meshes/link2.stl"/></geometry>
    </collision>
  </link>
  <joint name="joint2" type="revolute">
    <origin xyz="0.013 0 0.05122" rpy="-1.57079632679 0 0"/>
    <parent link="link1"/>
    <child link="link2"/>
    <axis xyz="0 0 1"/>
    <limit lower="-1.83259571459" upper="2.26892802759" effort="0.588" velocity="6"/>
  </joint>
  <link name="link3">
    <inertial>
      <origin xyz="0.01484 0.00744 0.0025" rpy="0 0 0"/>
      <mass value="0.0714"/>
      <inertia ixx="1.3758e-05" ixy="-7.469e-08" ixz="-1.53769e-06" iyy="1.73834e-05" iyz="2.9759e-07" izz="1.81406e-05"/>
    </inertial>
    <visual>
      <origin xyz="0.02416 0 0" rpy="1.57079632679 0 3.14159265359"/>
      <geometry><mesh filename="meshes/link3.stl"/></geometry>
      <material name="grey"><color rgba="0.8 0.8 0.8 1"/></material>
    </visual>
    <collision>
      <origin xyz="0.02416 0 0" rpy="1.57079632679 0 3.14159265359"/>
      <geometry><mesh filename="meshes/link3.stl"/></geometry>
    </collision>
  </link>
  <joint name="joint3" type="revolute">
    <origin xyz="0 -0.1 0" rpy="3.14159265359 0 -1.57079632679"/>
    <parent link="link2"/>
    <child link="link3"/>
    <axis xyz="0 0 1"/>
    <limit lower="-1.40202298813" upper="2.61799387799" effort="0.588" velocity="6"/>
  </joint>
  <link name="link4">
    <inertial>
      <origin xyz="-2e-05 0.02135 -0.07139" rpy="0 0 0"/>
      <mass value="0.0461"/>
      <inertia ixx="4.66724e-05" ixy="-1.577e-08" ixz="4.116e-08" iyy="3.83882e-05" iyz="1.53861e-05" izz="1.07566e-05"/>
    </inertial>
    <visual>
      <origin xyz="0 0 -0.09792" rpy="-1.57079632679 0 0"/>
      <geometry><mesh filename="meshes/link4.stl"/></geometry>
      <material name="grey"><color rgba="0.8 0.8 0.8 1"/></material>
    </visual>
    <collision>
      <origin xyz="0 0 -0.09792" rpy="-1.57079632679 0 0"/>
      <geometry><mesh filename="meshes/link4.stl"/></geometry>
    </collision>
  </link>
  <joint name="joint4" type="revolute">
    <origin xyz="0.02416 0 0" rpy="1.57079632679 0 3.14159265359"/>
    <parent link="link3"/>
    <child link="link4"/>
    <axis xyz="0 0 1"/>
    <limit lower="-3.14159265359" upper="3.14159265359" effort="0.588" velocity="6"/>
  </joint>
  <link name="link5">
    <inertial>
      <origin xyz="0.00464 3e-05 0.00048" rpy="0 0 0"/>
      <mass value="0.0351"/>
      <inertia ixx="3.42008e-06" ixy="3.215e-08" ixz="1.3694e-07" iyy="4.47832e-06" iyz="4.161e-08" izz="5.27248e-06"/>
    </inertial>
    <visual>
      <origin xyz="0 0 0" rpy="1.57079632679 0 0"/>
      <geometry><mesh filename="meshes/link5.stl"/></geometry>
      <material name="grey"><color rgba="0.8 0.8 0.8 1"/></material>
    </visual>
    <collision>
      <origin xyz="0 0 0" rpy="1.57079632679 0 0"/>
      <geometry><mesh filename="meshes/link5.stl"/></geometry>
    </collision>
  </link>
  <joint name="joint5" type="revolute">
    <origin xyz="0 0 -0.09792" rpy="-1.57079632679 0 0"/>
    <parent link="link4"/>
    <child link="link5"/>
    <axis xyz="0 0 1"/>
    <limit lower="-3.14159265359" upper="3.14159265359" effort="0.588" velocity="6"/>
  </joint>
  <link name="link6">
    <inertial>
      <origin xyz="0.00162 0.02617 -0.04571" rpy="0 0 0"/>
      <mass value="0.0553"/>
      <inertia ixx="9.01654e-05" ixy="2.77967e-06" ixz="-1.00802e-06" iyy="1.87513e-05" iyz="3.05318e-05" izz="7.6915e-05"/>
    </inertial>
    <visual>
      <origin xyz="0 0 -0.078277" rpy="3.14159265359 0 3.14159265359"/>
      <geometry><mesh filename="meshes/link6.stl"/></geometry>
      <material name="grey"><color rgba="0.8 0.8 0.8 1"/></material>
    </visual>
    <collision>
      <origin xyz="0 0 -0.078277" rpy="3.14159265359 0 3.14159265359"/>
      <geometry><mesh filename="meshes/link6.stl"/></geometry>
    </collision>
  </link>
  <joint name="joint6" type="revolute">
    <origin xyz="0 0 0" rpy="1.57079632679 0 0"/>
    <parent link="link5"/>
    <child link="link6"/>
    <axis xyz="0 0 1"/>
    <limit lower="-3.14159265359" upper="3.14159265359" effort="0.588" velocity="6"/>
  </joint>
  <link name="tcp"/>
  <joint name="tcp_joint" type="fixed">
    <origin xyz="0 0 -0.078277" rpy="3.14159265359 0 3.14159265359"/>
    <parent link="link6"/>
    <child link="tcp"/>
  </joint>
  <link name="gripper_trigger">
    <inertial>
      <origin xyz="-0.0131 0.0152 0.01278" rpy="0 0 0"/>
      <mass value="0.0143"/>
      <inertia ixx="4.94175e-06" ixy="1.37642e-06" ixz="-1.42386e-06" iyy="4.41935e-06" iyz="1.71948e-06" izz="4.54686e-06"/>
    </inertial>
    <visual>
      <origin xyz="0 0 0" rpy="0 0 0"/>
      <geometry><mesh filename="meshes/gripper_trigger.stl"/></geometry>
      <material name="grey"><color rgba="0.8 0.8 0.8 1"/></material>
    </visual>
    <collision>
      <origin xyz="0 0 0" rpy="0 0 0"/>
      <geometry><mesh filename="meshes/gripper_trigger.stl"/></geometry>
    </collision>
  </link>
  <joint name="gripper_trigger_joint" type="revolute">
    <origin xyz="0 -0.01129 -0.03571" rpy="-1.57079632679 0 -1.57079632679"/>
    <parent link="link6"/>
    <child link="gripper_trigger"/>
    <axis xyz="0 0 1"/>
    <limit lower="-1.57079632679" upper="1.57079632679" effort="0.588" velocity="6"/>
  </joint>
</robot>
