Source-Robotics/RAFT-teleoperation-arm/firmware/src/main/version.h

// RAFT firmware version (semantic versioning). The boot banner and the web UI show it with the build time;
// CHANGELOG.md at the repository root says what changed. Portable.
#pragma once

#define RAFT_VERSION "1.0.0"
