Source-Robotics/RAFT-teleoperation-arm/firmware/src/main/calibration.cpp

#include "calibration.h"

#include <math.h>
#include <stdio.h>
#include <string.h>

namespace raft {
namespace {

const float kPi = 3.14159265358979f;
const float kRunaway = 8.0f * kPi / 180.0f;      // abort if the joint gets this far from where it started
const float kTrackErr = 6.0f * kPi / 180.0f;     // abort if the joint lags the sweep by this much (3 deg was tripped by the real gear friction)
const float kMinLoad = 0.04f;                    // Nm: too little gravity load to calibrate against
const float kIntegMax = 0.25f;                   // Nm: PID integrator clamp
const int16_t kRawMax = 400;                     // register clamp during the sweep

}  // namespace

constexpr float Calibrator::kSweepAmpRad;
constexpr float Calibrator::kSweepSpeedRadS;
constexpr float Calibrator::kHoldS;
constexpr float Calibrator::kSkipS;

Calibrator::Calibrator()
    : kind_(CalibKind::None), joint_(-1), t_(0.0f), n_(0), stopRad_(0.0f), stopDir_(1), phase_(P_IDLE), phaseT_(0.0f), qStart_(0.0f),
      qMinSeen_(0.0f), qMaxSeen_(0.0f), integ_(0.0f), kp_(0.0f), ki_(0.0f), kd_(0.0f), tauNeed0_(0.0f), tauSpring0_(0.0f), sumCur_(0.0f), sumReg_(0.0f),
      mAPerUnit_(3.25f), ktAssumed_(0.441f), dirJ_(1), haveResult_(false)
{
    memset(&result_, 0, sizeof(result_));
    for (int i = 0; i < kNumJoints; ++i) { sum_[i] = 0; ref_[i] = 0; minD_[i] = maxD_[i] = 0; rMin_[i] = rMax_[i] = 0.0f; }
    for (int b = 0; b < 2; ++b) { sumCmd_[b] = sumGrav_[b] = sumSpring_[b] = 0.0f; nAvg_[b] = 0; }
}

const char* Calibrator::phaseText() const
{
    if (kind_ == CalibKind::None) return "idle";
    if (kind_ == CalibKind::Zero) return "zero: hold the arm in the CAD zero pose";
    if (kind_ == CalibKind::Stop) return "stop: hold the joint still against its stop";
    if (kind_ == CalibKind::Range) return "range: move every joint gently to both ends, then stop";
    switch (phase_) {
    case P_HOLD: return "sweep: holding still";
    case P_UP: return "sweep: moving + 4 deg";
    case P_DOWN: return "sweep: moving - 8 deg";
    case P_BACK: return "sweep: returning";
    default: return "sweep";
    }
}

void Calibrator::finish(bool ok, const char* msg)
{
    result_.kind = kind_;
    result_.joint = joint_;
    result_.ok = ok;
    strncpy(result_.msg, msg, sizeof(result_.msg) - 1);
    result_.msg[sizeof(result_.msg) - 1] = '\0';
    haveResult_ = true;
    kind_ = CalibKind::None;
    phase_ = P_IDLE;
}

void Calibrator::abort(const char* why)
{
    if (kind_ == CalibKind::None) return;
    finish(false, why);
}

bool Calibrator::startZero()
{
    if (active()) return false;
    memset(&result_, 0, sizeof(result_));
    haveResult_ = false;
    kind_ = CalibKind::Zero; joint_ = -1; t_ = 0.0f; n_ = 0;
    for (int i = 0; i < kNumJoints; ++i) { sum_[i] = 0; minD_[i] = 32767; maxD_[i] = -32767; }
    return true;
}

bool Calibrator::startStop(int joint, float stopRad, int dir)
{
    if (active() || joint < 0 || joint >= kNumJoints || (dir != 1 && dir != -1)) return false;
    if (!(stopRad > -kPi && stopRad < kPi)) return false;   // a reading is half a turn either way of the zero
    memset(&result_, 0, sizeof(result_));
    haveResult_ = false;
    kind_ = CalibKind::Stop; joint_ = (int8_t)joint; t_ = 0.0f; n_ = 0;
    stopRad_ = stopRad; stopDir_ = (int8_t)dir;
    sum_[joint] = 0; minD_[joint] = 32767; maxD_[joint] = -32767;
    return true;
}

void Calibrator::startSweep(int joint, const ControlConfig& cfg, CalibKind kind)
{
    memset(&result_, 0, sizeof(result_));
    haveResult_ = false;
    kind_ = kind; joint_ = (int8_t)joint; t_ = 0.0f; n_ = 0;
    phase_ = P_HOLD;
    phaseT_ = 0.0f;
    integ_ = 0.0f;
    // the MOVE impedance of this joint (validated in the simulator) plus an integrator with a 0.25 s time constant
    kp_ = cfg.joint[joint].moveK;
    kd_ = cfg.joint[joint].moveD;
    ki_ = 4.0f * kp_;
    for (int b = 0; b < 2; ++b) { sumCmd_[b] = sumGrav_[b] = sumSpring_[b] = 0.0f; nAvg_[b] = 0; }
    sumCur_ = sumReg_ = 0.0f;
    mAPerUnit_ = cfg.mAPerUnit;
    ktAssumed_ = cfg.joint[joint].ktNmPerA;
    dirJ_ = cfg.joint[joint].dir;
}

bool Calibrator::startTorque(int joint, const ControlConfig& cfg)
{
    if (active() || joint < 0 || joint >= kNumJoints) return false;
    startSweep(joint, cfg, CalibKind::Torque);
    return true;
}

bool Calibrator::startSpring(const ControlConfig& cfg)
{
    if (active() || cfg.spring.type == SpringType::None) return false;
    startSweep(1, cfg, CalibKind::Spring);
    return true;
}

bool Calibrator::startRange()
{
    if (active()) return false;
    memset(&result_, 0, sizeof(result_));
    haveResult_ = false;
    kind_ = CalibKind::Range; joint_ = -1; t_ = 0.0f; n_ = 0;
    return true;
}

bool Calibrator::stopRange()
{
    if (kind_ != CalibKind::Range) return false;
    finishRange();
    return true;
}

void Calibrator::finishRange()
{
    const float minSpan = 10.0f * kPi / 180.0f;
    result_.rangeMask = 0;
    char msg[120];
    int m = snprintf(msg, sizeof(msg), "range: measured");
    for (int i = 0; i < kNumJoints; ++i) {
        result_.qMinRad[i] = rMin_[i];
        result_.qMaxRad[i] = rMax_[i];
        if (n_ > 0 && rMax_[i] - rMin_[i] >= minSpan) {
            result_.rangeMask |= (uint8_t)(1u << i);
            if (m > 0 && m < (int)sizeof(msg))
                m += snprintf(msg + m, sizeof(msg) - (size_t)m, " J%d %.0f..%.0f", i + 1, (double)(rMin_[i] * 180.0f / kPi), (double)(rMax_[i] * 180.0f / kPi));
        }
    }
    if (!result_.rangeMask) { finish(false, "range: no joint was moved through 10 deg"); return; }
    finish(true, msg);
}
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
