Source-Robotics/RAFT-teleoperation-arm/(commit log)

2026-03-04 Initial text
    [MSG_Gripper_body_100mm.STEP, MSG_Gripper_body_150mm.STEP, MSG_Gripper_body_200mm.STEP, MSG_JAW_2_part.3MF, MSG_JAW_2_part.STEP, MSG_JAW_TPU_GLUE.3MF, MSG_JAW_TPU_GLUE.STEP, MSG_solid_jaw.STEP]
2026-05-04 Initial update
    [Base.STEP, Base_lid.STEP, Elbow.STEP, Elbow_llid.STEP, Gripper_handle.STEP, Gripper_trigger.STEP, Lower_arm.STEP, MSG_Gripper_body_100mm.STEP]
2026-05-05 Refactor BOM.md by removing mechanical components
    Removed redundant mechanical components section and adjusted BOM table.
2026-11-05 RAFT software 1.0.0
    The first release of RAFT with its software (CHANGELOG.md has the
    summary). Everything has run on the first arm, except teleoperation of
    PAR6, which is tested in simulation only.
    - Firmware for the Olimex ESP32-PoE: a 250 Hz control loop on its own
    core with a pipelined servo bus, gravity and friction compensation,
    hold and moves in the servos' position mode, calibration at the
    mechanical stops, settings in flash, a strict boot (torque off until
    all seven servos answer), short servo dropouts ridden through,
    updates over the network, an arm name (raft-<name>.local)
    - Teleoperation of PAR6 through its RCB runtime: Real RTI at 250 Hz or
    SOFT_RTI, clutch, realign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
    [Assem1.SLDASM.urdf, RAFT.urdf, base_link.stl, gripper_trigger.stl, link1.stl, link2.stl, link3.stl, link4.stl]
2026-11-05 Lid screws for the Shoulder and Elbow; RX0 to GPIO33 without a divider
    - Assembly manual 2b and 4a: the Shoulder and Elbow lids close with
    2 x M3 x 8 each (two counterbored holes in each lid's STEP)
    - BOM: M3 x 8 = 15 (2 on each of the three lids and the 4 joint stops,
    10 used, plus 5 spare); the divider resistors removed
    - Wiring in the manual and the bring-up guide: TTLinker RX0 goes
    straight to GPIO33, as on the first arm; bring-up 2.1 keeps one line
    that the line carries 5 V and a divider gives margin; the divider
    check and the troubleshooting mentions removed
2026-11-05 BOM: reference images
    - BOM reference images/: the HLS3606M with its box contents (Feetech
    datasheet), the ESP32-PoE (Olimex manual), the TTLinker mini (its
    datasheet), and Wikimedia Commons photos of a bench supply, a toggle
    switch, a PoE injector, an extension spring and braided line; the
    eyelet and PTFE slice rendered for RAFT. README.md there gives each
    picture's source and licence
    - BOM.md: a Reference Image column for the servo, electronics and
    counterbalance rows (as in the PAR6 and PAROL6 BOMs), and the note on
    broken links and reference images
    - README licensing table: the pictures keep their own licences
2026-11-05 Spring viewer and guide: the AliExpress springs
    - viewer_template.html: an AliExpress set on the a 13 / b 20 mount
    (0.8 x 6 x 35 main, 0.8 x 6 x 40, 0.8 x 7 x 30), rates estimated
    from the size, selected when the page opens
    - spring_mount.md: the ordered springs with estimated rate, balance,
    pre-stretch and rating at the end of J2's range; the 7 mm spring's
    1.3 mm gap to the bar; firmware starting rates 850 / 710 / 690 N/m
2026-11-05 Spring viewer: J3 counterbalance options A and B
    - A, across the elbow: anchor on a post at the upper arm's end, eyelet,
    spring and pin on an arm fixed to the elbow (tilted 25 deg up, clear
    of the wrist); exact only with the upper arm vertical
    - B, referenced to the shoulder: pulley fixed on the J2 post, free
    pulley at J3, 1:1 belt, anchor on the level pulley's lever; exact in
    every pose and takes the forearm's share off J2 as well (J2 spring
    pin moves to 94 mm for the axle)
    - Forearm load from the URDF (222 g, 0.165 Nm, centre of mass 75 deg
    from up); recommended mount p 10 mm, q from k p q = M3
    - J2/J3 gravity bars, readouts, clearance against the meshes, sweeps
    with peak ser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
2026-11-05 A servo back after a longer silence is read within half a turn of zero
    The arm reported J2 at -376.6 deg after its servo supply had been off
    for about 15 h while the ESP32 ran on: the unwrap counted a turn from
    the last angle before the outage. A servo that answers again after 63
    missed reads in a row (about 0.25 s) is now taken to be within half a
    turn of zero, as at power-up; a short dropout keeps the turn count.
    - app.cpp: kRewrapMissing, reset that joint's unwrap on its return
    - test_app: short dropout keeps the count; J2 moved +100 -> -100 deg
    while silent reads -100, not +260
    - app.h comment, CHANGELOG
    [app.cpp, app.h, test_app.cpp]
2026-11-05 BOM: servo and spring links, M2 for the ESP32-PoE; the springs are stainless
    - BOM: HLS3606M listing (Feetech HLS3606M on AliExpress); the J2 spring
    is the AliExpress 0.8 mm stainless 6 x 35 mm (packs of 5) with its
    link; M2 4-5 mm 33 -> 36 (+3 for the ESP32-PoE on the Base's posts)
    - Assembly manual step 9: the board fixed with 3 x M2
    - Spring guide and viewer: the listing says stainless, so the soft end
    of the estimate: 0.79 / 0.66 / 0.64 N/mm (91 / 76 / 74 %), firmware
    start k 790 / 660 / 640; ratings of a comparable stainless spring
2026-11-05 README gallery rendered from the MuJoCo model
    tools/render_gallery.py renders the arm from raft_description with the
    shells sorted as for the assembly manual (dark grey prints, black
    servos, aluminium horns, steel screws) and the ESP32-PoE from Olimex's
    board STEP: a front view, a back view and five poses, each in a light
    and a dark studio. The README shows the one matching the reader's
    GitHub theme.
2026-11-05 Rest pose: the arm lying back, then limp; BOM links for the TTLinker and eyelet
    Rest pose (Petar: where the arm rests limp): J2 -82 (2 deg short of
    its stop), J3 -80, wrist straight. In the CAD every part keeps 8 mm
    from the others and the handle 41 mm above the table, also on the
    straight move there from the usual poses; the old pose (J3 -70 with
    the upper arm vertical) put the handle 19 mm into the table.
    - control: the rest move is not clamped to the joint ranges (J3 folds
    below its J2 = 0 range with J2 lying back) and ends in LIMP (it ended
    in GRAVITY, which would hold J3's 360 mA at rest); the rest command
    and auto-rest both use it
    - test_model: parks at J2 -82 / J3 -80, goes limp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
    [app.cpp, control.cpp, control.h, raft_sim.cpp, test_model.cpp]
2026-11-06 Robot models move to robot_descriptions; coloured arm in the web UI
    RAFT's MuJoCo and URDF packages are now built and published in
    robot_descriptions, like PAR6's and PAROL6's. This repository keeps what the
    firmware needs:
    - firmware/tools/gen_model.py writes tools/sim/model/raft_reference.json, the
    model reference robot_descriptions builds RAFT's packages from: frames, mass
    properties, measured joint ranges, keyframes, actuation, the J2 spring sites
    and sample poses with FK and gravity torques for its checks. The firmware's
    own model (raft_model.h, golden_vectors.h) is unchanged.
    - The CAD meshes move next to the simulators' model (tools/sim/model/meshes).
    The simulators' J3 ran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
    [RAFT.urdf, base_link.stl, gripper_trigger.stl, link1.stl, link2.stl, link3.stl, link4.stl, link5.stl]
2026-11-06 README: the hero render is the cover; the gallery is gone
    Photos/RAFT_arm_img.png is now the arm with the handle held in front, in the
    dark studio. The gallery section and its six pictures are removed, and
    tools/render_gallery.py becomes tools/render_cover.py, which renders only the
    cover (it reproduces the picture within 1/255). The assembly manual names the
    model its pictures come from (firmware/tools/sim/model), not raft_description.
