Source-Robotics/RAFT-teleoperation-arm/(notices)

Notices in the files:
README.md:
Hardware: CERN-OHL-S-2.0
Software: GPL-3.0
